Alphonsusadt/Mixed-Signal-Delta-Sigma-ADC/README_F1_v3.md

# F1 v3 — opsi F5: clk komparator dari phi2b via rantai B6_INV
Berkas: top_level/closed_loop/run_closed_loop_f1.py (SALINAN yang menggantikan versi v2 Anda; baseline repo tidak diubah).
Baru: --clk-source {ideal|phi2b-chain} --clk-chain N (N genap). Default tetap ideal.
STATUS: NOT_RUN (hanya --check dan --selftest di sandbox pembuat, subckt dummy).
