Alphonsusadt/Mixed-Signal-Delta-Sigma-ADC/docs/reports/Block4_DAC_Report_EN.pdf

MIXED-SIGNAL IC DESIGN / ENGINEERING REPORT

## BLOCK 4

# Differential 1-Bit Feedback DAC

From an initial estimate to a verified transistor-level baseline

Alphonsus Aditya Putera Wahyudi

Biomedical Engineering / Universitas Gadjah Mada

Technology SKY130A, 1.8 V MOS devices
Clock / load 4 MHz / 1 pF per DAC output
Final DAC | Wn/Wp = 8/256 µm, L = 0.15 µm
Interface | StrongARM + two B01 buffers + SR latch
Evidence | 1,080 cases; 45 PVT points; two waveform reviews
Revision | 1.1 / 2 November 2026

Result status. Function and timing meet the pre-layout campaign criteria that were defined. These results are not a reliability sign-off, post-layout verification, or proof of the dynamic range of the complete ADC.

Independent design portfolio. English.

BLOCK 4 / DIFFERENTIAL 1-BIT DAC | English

## Contents

Revision note 1.1 | ii
Summary for the reader | ii
1 Design objective and scope of the work | 1
2 Theoretical basis and circuit implementation | 2
3 Initial calculation: expectations and assumptions | 4
4 Experimental method and measurement definitions | 6
5 Design evolution: results that changed decisions | 7
6 Final results from the Xschem export | 10
7 Discussion: what agrees and what does not yet | 14
8 Conclusion and the baseline retained | 17
A Reproducibility and final configuration | 18
B Index of experimental evidence | 18
C Summary of the final 45 PVT points | 18
Alphonsus Aditya Putera Wahyudi | i

## Revision note 1.1

Revision 1.1 (2 November 2026) only updates the reference to the system-level target, from about 99 dB to about 75 dB SNDR at OSR 80. No Block 4 data, device size, or conclusion has been changed.

## Summary for the reader

Block 4 converts a one-bit decision into two reference voltages that swap places. The final circuit remains simple: four CMOS transmission gates. The harder work lay in choosing a size that is strong enough in the worst-case condition, ensuring that the decision source is not disturbed by its load, and defining precisely when the output may be considered settled.
The pre-simulation note estimated an ON resistance of about 463 Ω and a settling time of 3.20 ns for a 1 pF load. That figure came from illustrative MOS parameters. The SKY130 model then gave 4.10 kΩ at mid-signal for the initial size Wn/Wp = 2/4 µm, and the actual settling reached 17.77 ns. The reference-selector architecture was therefore correct, but the hypothesis that the initial size was sufficient was rejected by the test results.
The 4/8 µm size improved the nominal condition but passed only 26 of 45 PVT points. The SF, 1.62 V, −40 ◦C case required 137.92 ns. Subsequent exploration led to the 8/256 µm size, which satisfies all 45 standalone points. The large PMOS width is a real cost of this solution: conduction improves, but the control load and parasitic effects increase.
Integration with the StrongARM comparator and the SR latch exposed a second problem. At a 1 mV input difference, the direct connection produced only six correct decisions out of 12 diagnostic cycles. The comparator without the latch and the circuit with ideal isolation were correct again. Two transistor-based B01 buffers were then inserted between the comparator and the latch. This change is supported by a loading diagnosis; its single physical mechanism is not claimed to have been fully isolated.
Final result from the Xschem export | Value
PVT campaign / passing cases | 45/45 / 1080/1080
Cases with 1 pF DAC / without DAC | 540 / 540
Maximum latch decision delay | 5.498 ns
Q/QB reaching the 1% rail band, maximum | 7.853 ns
DAC settling after control is stable, maximum | 6.400 ns
Maximum steady-state error | 1.254 µV
Unresolved decisions / unsettled edges | 0 / 0

The review of the two worst waveforms reproduces the summary figures and checks hold during reset. The total time from the start of the clock edge until the DAC is stable reaches 12.711 ns on the SF waveform. That figure differs from the 6.400 ns settling measured after the gate is stable. This difference in time definitions must be carried into the interface design of the next block.

Design decision. Keep the 8/256 µm DAC, L = 0.15 µm, and the two B01 buffers as the pre-layout function/timing baseline. Repeating optimization passes A–D is not supported by any new finding. The glitch budget, reference current, whole-transistor stress, noise/mismatch, and post-layout remain open.

Alphonsus Aditya Putera Wahyudi | ii

## 1 Design objective and scope of the work

### 1.1 Role of Block 4 in the modulator

The parent project targets a second-order switched-capacitor delta-sigma modulator with a nominal 1.8 V supply, 4 MHz sampling, and OSR 80. The sampling relation gives

Ts =

1
fs

= 250 ns, B =

fs
2 OSR = 25 kHz. | (1)

This bandwidth is an architectural relation, not the measured bandwidth of a finished ADC. The dynamic-range target is a system target: revision 1.0 of this report cited about 99 dB, and on 2 November 2026 the project owner revised it to about 75 dB SNDR at OSR 80 (see the Block 5 report). This revision concerns only the system-level target; the results and limits of Block 4 are unchanged. One-bit feedback is part of the delta-sigma loop [1]; the results of a reference-selector block are not sufficient to state the performance of the complete loop.
Block 4 selects the reference, while the sampling network and charge transfer are handled by Block 5. The non-overlapping clock generator is Block 6. This division matters: the 1 pF load in this report is a test load per output, not evidence that the entire downstream switched-capacitor interface has been modeled.

### 1.2 Questions to be answered

This report assesses whether the reference selection is correct, whether settling meets the budget, whether the nominal pass survives PVT, and whether the circuit keeps working when driven by a transistor-level comparator and latch. The next question is whether the Xschem implementation reproduces the behavior previously tested through the automation netlist.
This document is a retrospective synthesis. The initial expectations are taken from the pre-simulation note [S00]; the conclusions are then traced to experimental results. Rationalizations made after the measurements are not presented as numerical predictions made beforehand.

Table 1: Test specifications and the limits of their interpretation.

Parameter | Value used | Meaning
Nominal supply | 1.8 V | The PVT campaign uses 1.62, 1.8, 1.9 V.
Final nominal reference | 1.2 / 0.6 V | Differs from the initial rail-to-rail 1.8 / 0 V example.
Reference under PVT | 2VDD/3, VDD/3 | Not an absolute 1.2 / 0.6 V reference at every supply.
Integration test load | 1 pF per output | Does not yet include the switches, OTA, and Block 5 impedance.
DAC tolerance | 0.1% of reference span | Per-output settling criterion.
Settling budget | 10 ns after control | Not a 10 ns total clock-to-DAC time.
Latch decision budget | 100 ns | Separate from the 1% rail requirement.
Alphonsus Aditya Putera Wahyudi | 1

## 2 Theoretical basis and circuit implementation

### 2.1 Differential and common-mode transfer

Define the decision D = Q ∈ {0, 1} and D = QB. With ∆VREF = VREFP − VREFN > 0, the ideal outputs are

VP = DVREFP + (1 − D)VREFN, | (2)
VN = DVREFN + (1 − D)VREFP, | (3)
Vd = VP − VN = (2D − 1)∆VREF, | (4)

VCM =

VP + VN
2

=

VREFP + VREFN
2
. | (5)

At the nominal 1.2/0.6 V references, Vd = ±0.6 V, the peak-to-peak differential swing is 1.2 V, and the ideal common mode is 0.9 V. At the 1.62 V PVT point the references become 1.08/0.54 V, so Vd = ±0.54 V and the common mode is 0.81 V.

Q | QB | VP | VN | Vd
0 | 1 | VREFN | VREFP | −∆VREF
1 | 0 | VREFP | VREFN | +∆VREF

The state Q = QB is not part of the ideal operating table. During a transition, both controls are analog voltages with finite rise/fall times; for a moment both may partially turn on different paths. A logic table alone therefore does not explain reference current or glitch.

### 2.2 Four transmission gates and pin order

Each TG consists of one NMOS and one PMOS in parallel. This combination is used to compen-sate for the conduction weakness of each device type over different parts of the signal range [3]. The TG is on when the NMOS gate is high and the PMOS gate is low. The NMOS bulk is tied to GND; the PMOS bulk to VDD.

TG X1
p : Q, n : Q

TG X3
p : Q, n : Q

TG X2
p : Q, n : Q

TG X4
p : Q, n : Q

VREFP

VREFN

VREFN

VREFP

DAC_P

DAC_N

Q = 1: X1, X2 ON
Q = 0: X3, X4 ON
Each TG: NMOS 8/0.15
and PMOS 256/0.15
(µm)

Figure 1: Functional connections of the final DAC. The numbers X1–X4 follow the tested export netlist; these labels are the reference that prevents numbering from being swapped between figures.

Table 2: Pin mapping taken from the final implementation [S22].

Instance A | B | PMOS gate | NMOS gate
X1 | VREFP | DAC_P | QB | Q
X2 | VREFN DAC_N QB | Q
X3 | VREFN DAC_P | Q | QB
X4 | VREFP | DAC_N Q | QB

The TG subcircuit pin order is A B CLK_P CLK_N VDD GND. The DAC pin order is VREFP VREFN Q QB VDD GND DAC_P DAC_N. The DAC contains four NMOS and four PMOS devices, all with L = 0.15 µm, nf=1, mult=1. The final sizes are 8 µm for each NMOS and 256 µm for each PMOS. This DAC cell is independent of the TG used by the CMFB; changing the DAC size does not automatically change the Block 2 cell.

### 2.3 Why the comparator needs a tested interface

The StrongARM produces a dynamic output that returns to its reset state every cycle. The SR latch stores the decision so that Q/QB remain available during that reset. The non-inverting B01 buffer uses two inverters per branch, so the polarity from the comparator to the latch input is

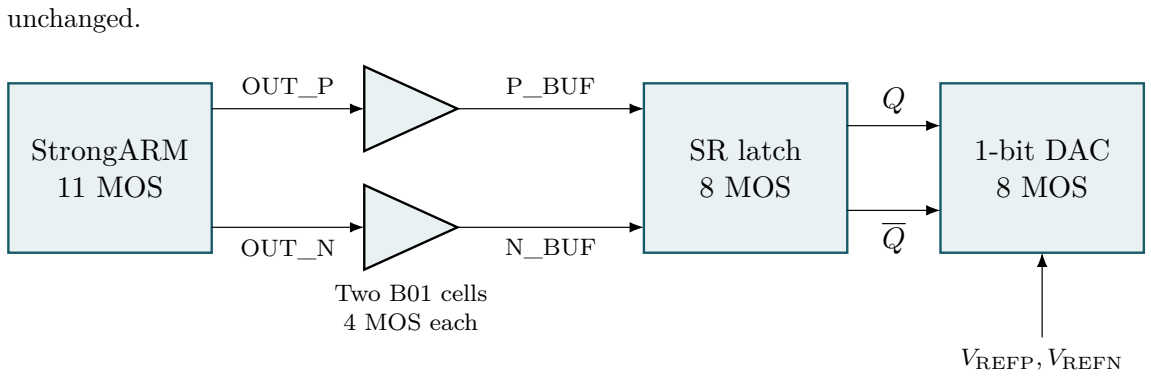
[picture p26: figure]
unchanged.; StrongARM 11 MOS; SR latch 8 MOS; 1-bit DAC 8 MOS; OUT_P; OUT_N; P_BUF; N_BUF; Two B01 cells 4 MOS each; VREFP, VREFN

Figure 2: Final interface: 11 comparator MOS, 8 MOS for the two buffers, 8 latch MOS, and 8 DAC MOS; 35 MOS in total in the loaded configuration.

The buffer is placed between the comparator and the latch. It does not remove the DAC gate load that the latch Q/QB outputs must still drive. This separation explains why DAC characterization and interface testing remain two distinct pieces of work.
The latch core uses two cross-coupled NAND gates with active-low inputs SN and RN:
Q = SN · QB, | QB = RN · Q. | (6)

With SN = 0, RN = 1, Q is set high; with SN = 1, RN = 0, Q is reset low. When the comparator resets and both inputs go high, the latch holds its previous state. Both inputs low is not an allowed storage state because it forces Q and QB high together. This is the physical reason retention must be checked, not assumed from the cell name.
As a local model of regeneration, the comparator output difference can be written vd(t) ≈ vd0 exp(t/τreg), so that

treg ≈ τreg lnVdecision
|vd0|
, | τreg ∼
| Cnode
| gm,reg
. | (7)

This model predicts that a smaller initial signal or a larger node load can slow the decision. No gm or Cnode was extracted here to predict a numerical delay. From the netlist sizes, the NAND-gate proxy seen directly by each comparator output is (2 + 2)0.15 = 0.60 µm²
, whereas the B01 input
is only (0.5 + 1)0.15 = 0.225 µm²
. The reduction of the proxy to 37.5% supports the choice of a small buffer; it is not a measurement of the actual capacitance.

## 3 Initial calculation: expectations and assumptions

### 3.1 ON-resistance model

To obtain an estimate before using the PDK model, the linear channel conductance is approxi-mated by

gn ≈ µnCox

Wn
L
max(VDD − Vsig − VT n, 0), | (8)

gp ≈ µpCox

Wp
L
max(Vsig − |VT p|, 0), | (9)

RON ≈ (gn + gp)

−1
. | | (10)

This equation simplifies the effects of body bias, short channels, and voltage change along the transition. The initial note used µnCox = 200 µA/V²

| , µpCox = 80 µA/V² | , and VT n = |VT p| =
0.45 V. These values are illustrative assumptions, not SKY130 extraction results.

With Wn/Wp = 2/4 µm, L = 0.15 µm, VDD = 1.8 V, and Vsig = 0.9 V:

gn = (200 × 10−6
)(2/0.15)(0.45) = 1.20 mS, | (11)
gp = (80 × 10−6
)(4/0.15)(0.45) = 0.96 mS, | (12)
RON ≈ 1/(2.16 mS) = 462.96 Ω. | (13)

The initial hypothesis was clear: if this resistance represents the path actually used, the inherited 2/4 size should be sufficient for the chosen settling budget. It is this hypothesis that was tested, not one assumed to be true because the equation looked reasonable.

### 3.2 RC settling derivation and resistance budget

For one branch with an ideal reference, constant RON, and capacitor CL,

CL

dVo
dt =

Vtarget − Vo

| RON
| . | (14)

The solution gives the normalized residual

en(t) = exp[−t/(RONCL)], | tϵ = RONCL ln(1/ϵ). | (15)

With CL = 1 pF and ϵ = 10−3
,
t0.1%,initial = 462.96 × 10−12 ln(1000) = 3.198 ns. | (16)

Conversely, the 10 ns budget gives the guideline

RON ≲

10 ns
1 pF ln(1000) = 1.448 kΩ. | (17)

For loads of 0.1 pF and 20 fF, the same model predicts 0.320 ns and 0.064 ns, respectively. Values this small can no longer be separated from the 1 ns control edge and the internal switch capacitance; the prediction only shows the ideal RC scale.

### 3.3 Why a single RC constant can miss

The effective source and drain of the TG change with the signal. When both terminals are near mid-supply, the NMOS VGS and PMOS VSG both shrink, while bulk bias raises the magnitude of the effective threshold. The simple body-effect form for an NMOS is

VT = VT0 + γ

(√
2ϕF + VSB −

√
2ϕF

)
. | (18)

No value of γ was extracted in this work. The equation explains the direction of the effect; it does not compute the numerical threshold of the final transistors. The illustrative 0.45 V threshold is not sufficient to represent all bias conditions of the standard model used.
If the current varies strongly with voltage, the transition time is better viewed through

t = CL

∫ Vb

Va

dV

Ipath(V )

, | (19)

with the direction of integration adjusted for charging or discharging. A weakly conducting region can dominate the integral even when the resistance near the rail is low. Therefore the minimum RON cannot represent the whole transition.

### 3.4 Reference energy and the cost of the control load

One bit change swaps both outputs. For two equal loads CL, the charge moved in each branch is

∆q = CL∆VREF = 1 pF(0.6 V) = 0.6 pC. | (20)

The ideal net reference energy for one reversal of the output pair is

Eref = VREFPCL∆VREF − VREFNCL∆VREF = CL∆V

2
REF = 0.36 pJ. | (21)

If α denotes the probability that the bit changes per sample,

Pref,ideal = αfsCL∆V

2
REF. | (22)

The result is 1.44 µW for α = 1 and 0.72 µW for α = 0.5. For the initial rail-to-rail 1.8/0 V example, the corresponding figures are 3.24 pJ and 12.96 µW for α = 1. This ninefold reduction comes from the change of reference span, not from evidence that efficiency improved ninefold through size optimization.
Each Q or QB drives two DAC NMOS and two DAC PMOS devices. The gate-area proxy driven by one node is
Agate,Q = 2(Wn + Wp)L. | (23)

Its value grows from 1.8 µm²

for 2/4 to 79.2 µm²
for 8/256, a factor of 44. Using only the initial illustration Cox,ef f = 5 fF/µm²
, the capacitance proxy changes from 9 to 396 fF per Q/QB. The 396 fF figure is not an extracted capacitance; overlap, channel bias, and routing are not covered. Likewise, ∑W L of the eight DAC MOS devices increases from 3.6 to 158.4 µm²
. This is a channel
metric, not layout area. It is useful for comparing candidates but excludes contacts, diffusion, wells, spacing, and metal.

### 3.5 Glitch and charge on the released node

A simple coupling estimate gives

∆Vf t ∼

Ccouple
CL
∆Vcontrol, | ∆Vq ∼

∆qinj
CL
. | (24)

The initial example Ccouple = 2 fF gives 3.6 mV at 1 pF and an 1.8 V edge. This is only an arithmetic example. The change in final dimensions and the sum of several mechanisms mean it is not a prediction of the final amplitude. Parasitic gate coupling and channel charge transfer can disturb analog nodes; adding width to reduce resistance also brings a parasitic cost [4].

## 4 Experimental method and measurement definitions

### 4.1 From the automation netlist to the Xschem export

Python automation assembles the decks, runs ngspice, reads the waveforms, and tests the criteria. Python does not replace the electrical circuit solution. The electrical results in this report come from ngspice in the user’s environment with the SKY130 model, not from a software test fixture. Code inspection and dry runs only validate the assembly and data analysis.
The early stage used a parametric netlist backend. After the size and interface were chosen, the schematic was built in Xschem and exported. The final tests use the fixed sizes from that export. Stage names and result rows distinguish these two phases so that backend results are not simply equated with schematic results.

Table 3: Test sequence and the design question of each.

Stage Test | Question
4A | Logic and output values | Is the reference selected with the correct polarity?
4B | DC RON, load, settling | How strong is the switch over the tested signal range?
4C | Edges, skew, node release | What are the transient cost and the control asymmetry?
4D | 45 standalone PVT points | Does the nominal size withstand the defined variation?
4E | Comparator–buffer–latch–DAC | Does the complete interface work with transistor drivers?

### 4.2 DC resistance: small differential measurement

The fixture applies a voltage difference δ = 1 mV symmetrically about the common-mode voltage, then compares the currents for positive and negative polarity:

GON (VCM ) = −

I+(VCM ) − I−(VCM )
2δ

, RON = G

−1
ON . | (25)

The minus sign follows the SPICE source-current convention in the deck. A 61-point sweep covers almost the entire 0–VDD range. Comparing the two polarities removes the first-order common-mode leakage component. The result is still a local measurement at small VDS; it is not a single constant resistance for all transitions.

### 4.3 Definitions of settle and hold

For each bit, the per-branch target is set by Equation (4). The test error is

e(t) = max (|VP − VP,target|, |VN − VN,target|). | (26)

The tolerance etol = 0.001∆VREF is 0.60 mV nominally and 0.54 mV at VDD 1.62 V. Settling is determined from the last sample that still fails, then the next sample that meets the tolerance through the end of the window with a minimum persistence time of 20 ns. The first crossing alone is not sufficient.
With ideal control, the settling start is the completion of both control ramps. With transistor integration, the start is when Q and QB both enter the 1% rail band. The latch decision delay uses a 30%/70% logic threshold, while the comparator is judged by the polarity of its regenerative output. These three metrics are deliberately not merged.
With t0 the start of the clock edge and tg the time at which control reaches the rail,
tDAC,af ter = tDAC,stable − tg, | tclock→DAC = tDAC,stable − t0. | (27)

Adding two maxima from different cases is not a total measurement of one waveform. The total must be computed on the same transition.

### 4.4 Numerical validity and the limits of PASS status

The final deck uses the trapezoidal method, reltol=1e-5, vntol=1e-8, abstol=1e-13, and a maximum time step of 0.05 ns. The log confirms the 10−6 geometry scale and the ngspice-46 simulator. Waveforms are saved with wrdata; the transient facilities and control language follow the ngspice documentation [5].
A case that times out or fails to load a Python module is not an electrical result that fails the specification; it must be fixed and rerun until valid data are available. Conversely, an ngspice process that finishes is not evidence that the circuit passes. The pipeline requires a valid execution status, complete data, and function and timing checks. The cache checks the identity of the deck, simulator, and model dependencies so that old results are not used for a changed configuration.

## 5 Design evolution: results that changed decisions

### 5.1 Initial 2/4 size: the model was too optimistic

The nominal DC result shows RON(0.9 V) = 4098.08 Ω, a minimum of 463.21 Ω, and a maximum of 5802.37 Ω [S02]. The minimum value, which happens to be close to the initial estimate, does not validate the mid-signal estimate. Comparison at the same mid-point gives

RON, sim(0.9 V)
RON, initial =

4098.08
462.96
| = 8.85. | (28)

Settling at the 1.2/0.6 V reference and a 1 pF load reached 17.77 ns, whereas the initial estimate was only 3.20 ns. This difference supports rejecting the illustrative parameters as a quantitative sizing tool. The available data do not separate the contributions of threshold, mobility, and body effect numerically; the physical explanation is consistent with TG bias but is not an extraction of the mechanism.

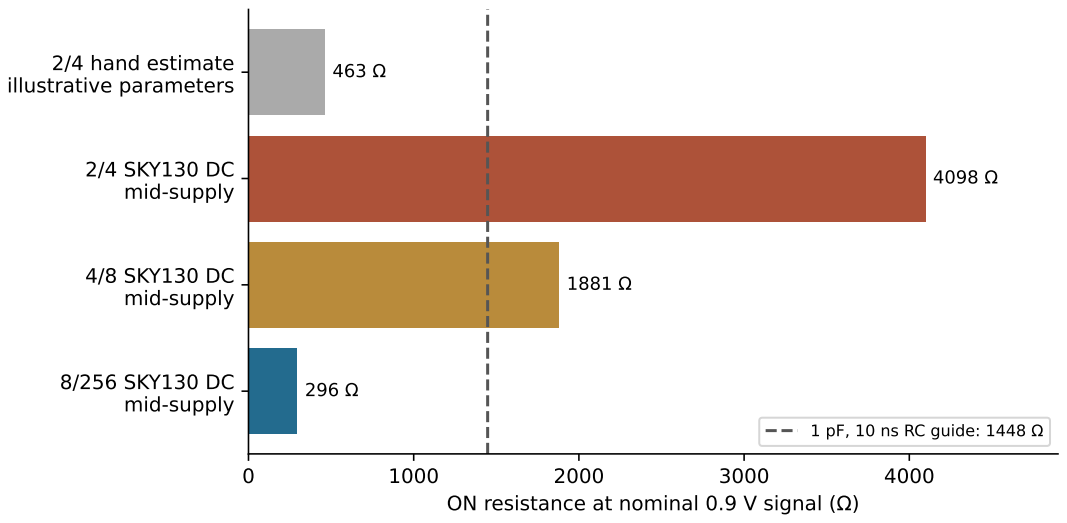
[picture p27: figure]
2/4 hand estimate illustrative parameters; 2/4 SKY130 DC mid-supply; 4/8 SKY130 DC mid-supply; 8/256 SKY130 DC mid-supply; 1 pF, 10 ns RC guide: 1448

ON resistance at nominal 0.9 V signal ( )

Figure 3: Initial estimate versus DC resistance at the same signal points. The dashed line is the 1 pF/10 ns RC guideline, not a universal threshold for every transition.

5.2 4/8 size: a nominal improvement is not enough

Doubling both widths reduces the mid-point RON from 4098 to 1881 Ω. The maximum settling of the nominal sweep becomes 8.763 ns; the 4/8 choice has the smallest ∑W L among the candidates

meeting that stage [S03]. Test 4A passes 6/6 and 4C completes 54/54: 45 switching transients plus nine release characterizations [S04,S05].
However, PVT passes only 26/45. At SF, 1.62 V, −40 ◦C, settling grows to 137.923 ns. A reduced time step gives 137.893 ns, a change of about 0.022%, so this large failure does not disappear through that refinement alone [S06,S07]. This result refutes the hypothesis that a nominal pass can be transferred directly to the whole PVT grid.
DC measurement at the failing condition finds a maximum RON of about 145.18 kΩ. At the same corner, settling for 20 fF, 0.1 pF, and 1 pF is 4.825, 15.662, and 137.923 ns [S08]. The load dependence supports the explanation of limited conduction. The local maximum resistance must not be directly multiplied into a full settling prediction because it does not hold along the entire voltage path.

### 5.3 Final 8/256 size and the cost of the solution

Worst-condition screening shows that adding NMOS alone is not sufficient: 8/8 still requires 128.70 ns, whereas 8/16 and 8/32 give 70.61 and 38.50 ns [S09]. After the search was extended, the selected 8/256 candidate passes 45/45 with a standalone maximum of 7.084 ns [S10]. This candidate is not evidence of a global optimum. The size grid is limited, and the area objective does not yet include layout cost, power, and all transient limits.
As a retrospective check, assuming ts ∝ 1/Wp from the 8/32 point would give Wp,trial ≈ 32(38.50/10) = 123.2 µm for a 10 ns target. However, the same assumption predicts only 38.50(32/256) = 4.81 ns at 8/256, faster than the actual result of 7.084 ns. Inverse width scaling therefore helps set the search direction but is not sufficient to determine the final size. Capacitance growing with width and a conduction path that is not purely PMOS may limit the improvement; their contributions were not extracted separately. This retrospective calculation is not claimed to have been made before the search took place.

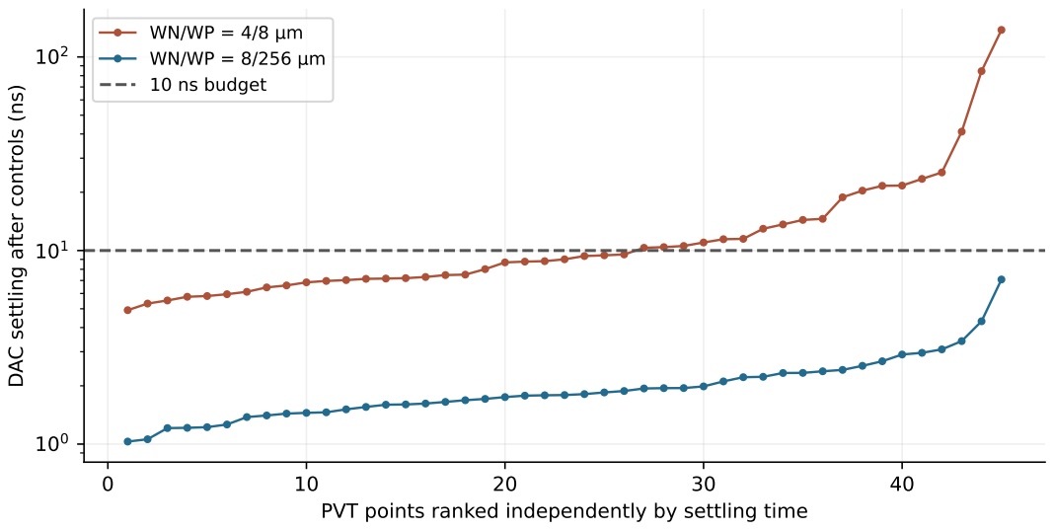
[picture p28: figure]
DAC settling after controls (ns); 10 ns budget

PVT points ranked independently by settling time

Figure 4: Distribution of settling over the 45 standalone PVT points. The points of each curve are sorted independently; the horizontal axis is not the same corner pair. The 4/8 size fails 19 points, whereas 8/256 meets this entire grid.

At nominal, the final candidate has a mid-point RON of 296.34 Ω, a maximum of 365.85 Ω, and a maximum 4B sweep settling of 1.880 ns [S11]. The RC model using the maximum resistance gives 365.85 Ω × 1 pF × ln(1000) = 2.527 ns. The nanosecond scale agrees, but the difference between 2.527 and 1.880 ns remains plausible because the voltage has already moved during the control ramp and the resistance is not constant. The simple model succeeds as a scale check, not as a precise predictor.

### 5.4 The 1 mV integration problem and loading diagnosis

After the standalone DAC passed, integration without a buffer completed 24 simulations, but only 18 met the criteria. The six failures were at the 1 mV input difference, including the configuration without a DAC [S13]. Blaming the DAC size alone therefore does not explain all of the data.

Table 4: Experiments separating the influence of loading [S14].

Configuration | Comparator correct | Output correct | Hold correct
Original connection, 1 mV | 6/12 | 6/12 | 6/12
Original connection, half time step | 6/12 | 6/12 | 6/12
Comparator without latch | 12/12 | 12/12 | –
Latch with diagnostic ideal isolation | 12/12 | 12/12 | 12/12
Original connection, 5 mV | 12/12 | 12/12 | 12/12

Ideal isolation was used to test the cause, not kept as a physical solution. Together, these results support an influence of the comparator–latch interaction at small signals. The terms loading, back-action, and regeneration describe possible mechanisms; these data do not measure the contribution of each separately.
Four physical buffer sizes B01–B04 were tested and all passed the six 1 mV screening cases. B01 was chosen because its additional channel proxy is the smallest, 1.35 µm²
for both branches. Each
buffer uses an inverter with Wn/Wp = 0.5/1 µm followed by 1/2 µm, all with L = 0.15 µm. B01 then passed nominal verification 24/24 [S15]. This selection proves the sufficiency of B01 within the test space, not that a larger buffer would never be needed at other loads.

### 5.5 Moving the design to an inspectable schematic

The Xschem DAC export passes 4A 6/6 and standalone PVT 45/45, with a maximum of 7.073 ns [S16,S17]. The value is close to the backend 7.084 ns but is reported separately. The complete integration export then passes 24/24 nominal [S18].
The final netlist shows MOS bulks connected, consistent interface pins, two physical B01 buffers, and fixed 8/256 sizes. In the automation deck, the two buffers are wrapped inside a subcircuit named SR_Latch, while the two-NAND core is kept as SR_Latch_CORE. This hierarchical placement does not mean the buffers disappeared, and it does not require adding a second buffer.

## 6 Final results from the Xschem export

### 6.1 Campaign coverage and passes

The final campaign contains five corners TT/SS/FF/SF/FS, three supplies 1.62/1.8/1.9 V, and three temperatures −40/27/125 ◦C. Thus

NP V T = 5 × 3 × 3 = 45. | (29)

At each point there are four input-difference magnitudes 1/5/10/50 mV, three patterns alternating/repeats/PRBS, and two configurations loaded/unloaded:

Ncase = 45 × 4 × 3 × 2 = 1080. | (30)

Of these, 540 cases connect the DAC with a 1 pF load per branch; the other 540 test the comparator–buffer–latch without a DAC. All use a fixed input common mode of 0.9 V; this is not a common-mode sweep. The analog and reference sources are ideal low-impedance sources; the PRBS pattern uses a fixed seed, not random mismatch samples.
All cases have OK execution status and pass the function, settling, and preliminary criteria. There is no unresolved decision, unsettled gate, or unsettled edge. The case count and the uniqueness of point/ID pairs were rechecked from the CSV [S19,S20,S21]. The 1080/1080 figure is deterministic coverage, not an estimate of production yield.

1.62 | 1.80 | 1.90

40

27

Latch decision (ns)

125

Temperature (°C)

4.92 | 4.12 | 3.83
4.91 | 4.24 | 3.94
5.04 | 4.43 | 4.18

TT

1.62 | 1.80 | 1.90

40

27

125

5.50 | 4.59 | 4.27
5.43 | 4.61 | 4.33
5.50 | 4.82 | 4.56

SS

1.62 | 1.80 | 1.90

40

27

125

4.45 | 3.77 | 3.55
4.43 | 3.89 | 3.68
4.70 | 4.16 | 3.99

FF

1.62 | 1.80 | 1.90

40

27

125

4.94 | 4.07 | 3.76
4.87 | 4.14 | 3.86
4.91 | 4.28 | 4.06

SF

1.62 | 1.80 | 1.90

40

27

125

4.94 | 4.22 | 3.95
5.00 | 4.34 | 4.06
5.23 | 4.62 | 4.39

FS

1.62 | 1.80 | 1.90
| VDD (V)

40

27

DAC after gates (ns)

125

Temperature (°C)

2.00 | 0.85 | 0.60
1.60 | 0.75 | 0.45
0.50 | 0.00 | 0.00
1.62 | 1.80 | 1.90
| VDD (V)

40

27

125

4.00 | 1.40 | 0.95
2.20 | 1.15 | 0.80
1.25 | 0.30 | 0.00
1.62 | 1.80 | 1.90
| VDD (V)

40

27

125

1.20 | 0.40 | 0.20
0.90 | 0.25 | 0.05
0.10 | 0.00 | 0.00
1.62 | 1.80 | 1.90
| VDD (V)

40

27

125

6.40 | 0.85 | 0.60
1.45 | 0.80 | 0.55
0.70 | 0.15 | 0.00
1.62 | 1.80 | 1.90
| VDD (V)

40

27

125

2.10 | 0.95 | 0.60
1.85 | 0.70 | 0.35
0.15 | 0.00 | 0.00

Final Xschem campaign: maxima across 24 cases per PVT point

Figure 5: Maximum over the 24 cases at each PVT point. Top row: latch decision delay. Bottom row: DAC settling after control is stable, maximum over the loaded cases. All figures in ns.

### 6.2 Worst metrics and where they occur

Table 5: Extremes of the final campaign. The values come from different cases and are not summed into a single waveform.

Metric | Maximum Corner / VDD / temp. / ID
Latch delay | 5.498 ns | SS / 1.62 / 125 / 0001
Gate reaching 1% rail | 7.853 ns | SS / 1.62 / 125 / 0001
DAC settling after gate | 6.400 ns | SF / 1.62 / −40 / 0013
Steady-state error | 1.254 µV SS / 1.62 / 125 / 0015
Excursion beyond reference | 38.775 mV FS / 1.90 / −40 / 0019
Peak reference current | 2.207 mA | FF / 1.90 / 27 / 0001
DAC terminal-pair proxy | 1.913 V | SF / 1.90 / −40 / 0007
Transient common-mode excursion | 229.105 mV SS / 1.62 / −40 / 0001

A settling time of 6.400 ns leaves 3.600 ns against the 10 ns post-gate budget. The 1% rail limit uses 16.2 mV at VDD 1.62 V. These two kinds of tolerance must not be confused with the 0.54 mV analog DAC tolerance.

### 6.3 Waveform review: slowest decision

The case SS/1.62 V/125◦C, ID 4E_0001, uses an input difference of ±1 mV. The waveform has 62,794 samples up to 3.1 µs. Recomputation gives a latch delay of 5.498 ns, a gate time of 7.853 ns, and an additional DAC settling of 1.200 ns. The maximum total clock-to-DAC time in this waveform is 9.053 ns [S23,S24].

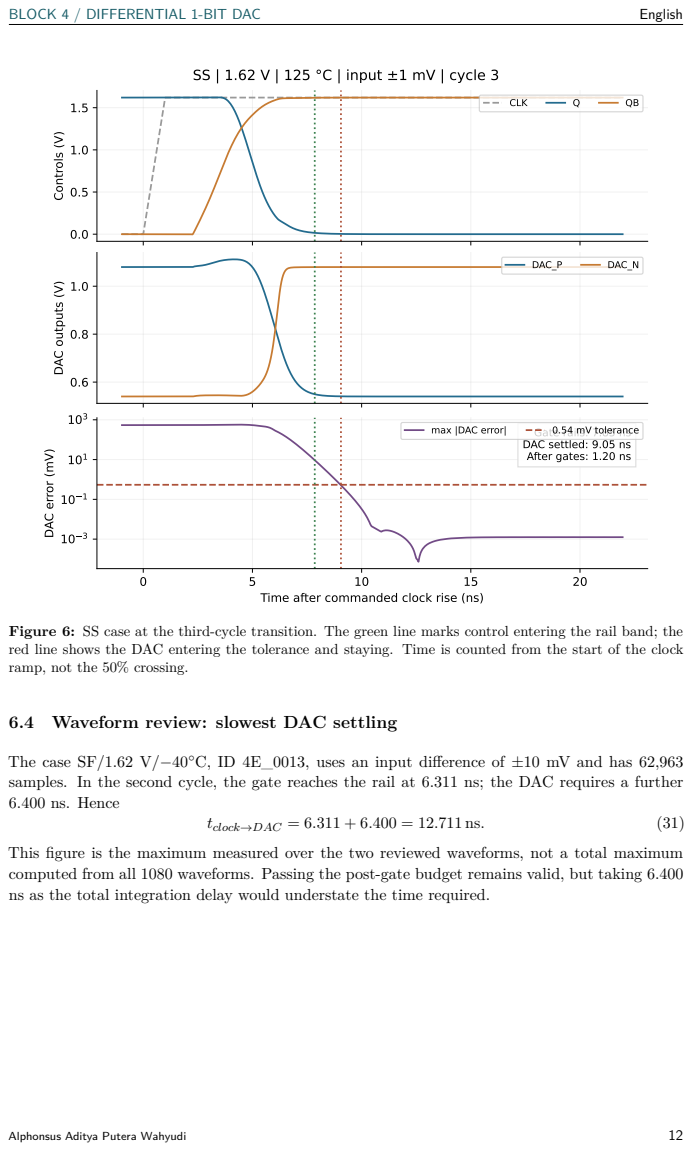
[picture p29: page 15]
Controls (V); CLK; DAC outputs (V); DAC_P; DAC_N; max |DAC error|; 0.54 mV tolerance; tclock→DAC = 6.311 + 6.400 = 12.711 ns.

SS | 1.62 V | 125 °C | input ±1 mV | cycle 3

Gate rails: 7.85 ns
DAC settled: 9.05 ns
After gates: 1.20 ns

DAC error (mV)

Time after commanded clock rise (ns)

Figure 6: SS case at the third-cycle transition. The green line marks control entering the rail band; the
red line shows the DAC entering the tolerance and staying. Time is counted from the start of the clock
ramp, not the 50% crossing.

6.4 Waveform review: slowest DAC settling

The case SF/1.62 V/−40◦C, ID 4E_0013, uses an input difference of ±10 mV and has 62,963
samples. In the second cycle, the gate reaches the rail at 6.311 ns; the DAC requires a further
6.400 ns. Hence

This figure is the maximum measured over the two reviewed waveforms, not a total maximum
computed from all 1080 waveforms. Passing the post-gate budget remains valid, but taking 6.400
ns as the total integration delay would understate the time required.

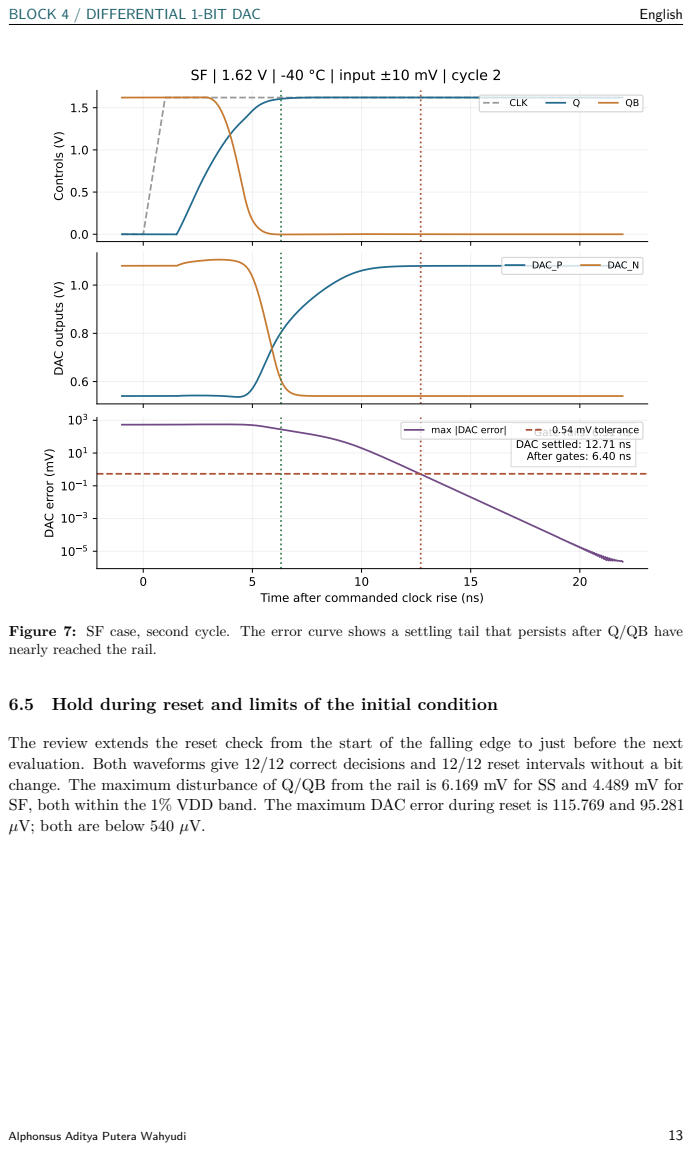
[picture p30: page 16]
Controls (V); CLK; DAC outputs (V); DAC_P; DAC_N; max |DAC error|; 0.54 mV tolerance

SF | 1.62 V | -40 °C | input ±10 mV | cycle 2

Gate rails: 6.31 ns
DAC settled: 12.71 ns
After gates: 6.40 ns

DAC error (mV)

Time after commanded clock rise (ns)

Figure 7: SF case, second cycle. The error curve shows a settling tail that persists after Q/QB have
nearly reached the rail.

6.5 Hold during reset and limits of the initial condition

The review extends the reset check from the start of the falling edge to just before the next
evaluation. Both waveforms give 12/12 correct decisions and 12/12 reset intervals without a bit
change. The maximum disturbance of Q/QB from the rail is 6.169 mV for SS and 4.489 mV for
SF, both within the 1% VDD band. The maximum DAC error during reset is 115.769 and 95.281
µV; both are below 540 µV.

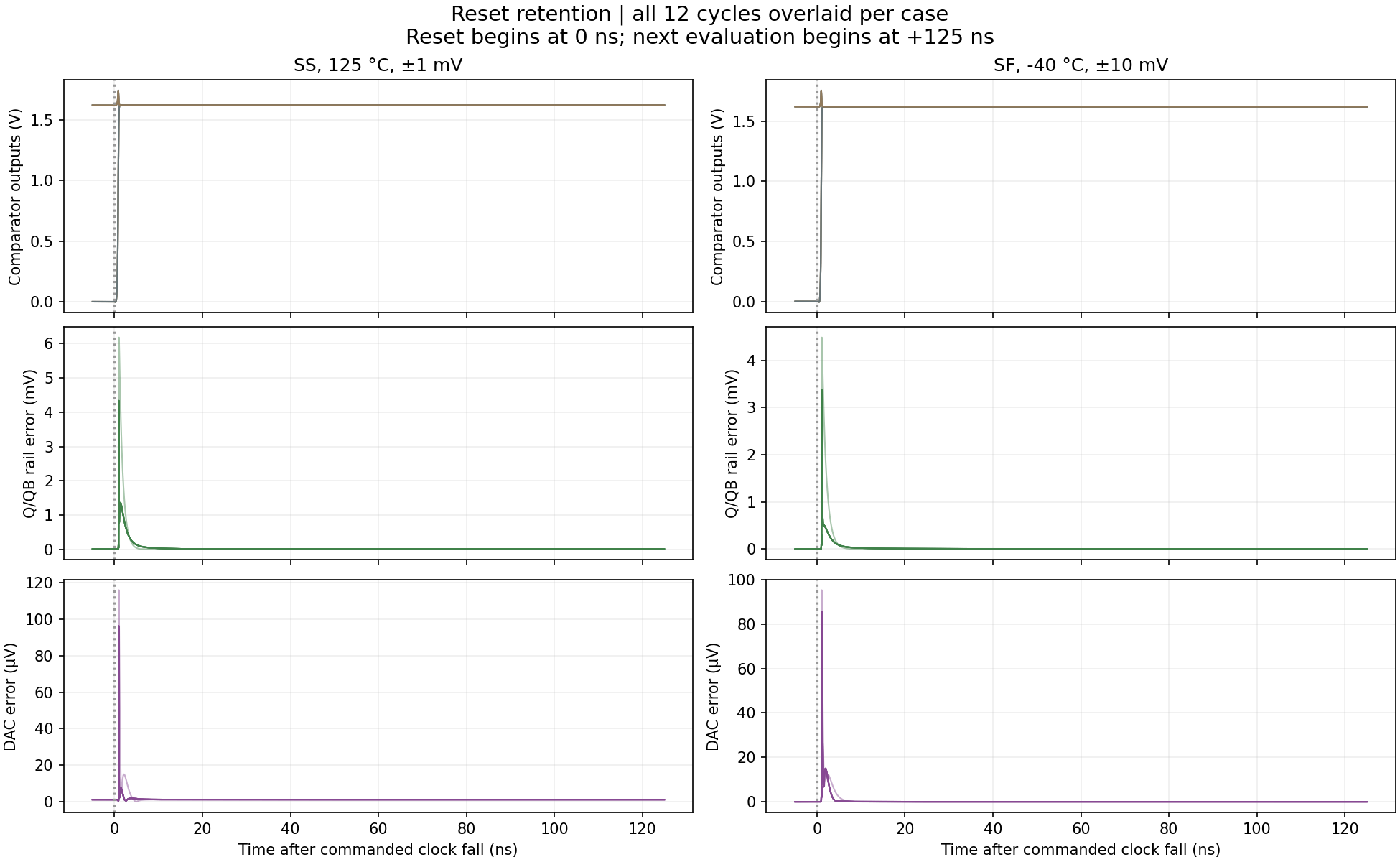
[picture p31: figure]

Figure 8: Twelve reset intervals overlaid per case. The comparator returns high; the latch rail error and DAC disturbance decay without a change of decision. The right and left axes have different scales.

The first cycle already has Q=0 from the DC operating-point solution. A zero delay in the first row is therefore not evidence that the circuit has a physical zero delay or a guaranteed random startup. The two waveforms contain 22 bit changes that were actually tested after the two initial states. No warnings, errors, or early terminations were found in either log.

## 7 Discussion: what agrees and what does not yet

### 7.1 Reconciling hypotheses with evidence

Table 6: Expectations, results, and updated design understanding.

Expectation | Test result | Explanation / decision
Four TGs give ±∆VREF outputs with fixed CM in the steady state. | Polarity and steady state agree. | Transfer structure kept; the CM transient must still be assessed.
2/4 suffices because the initial RC is 3.20 ns. | Settling 17.77 ns; mid-point DC 4.10 kΩ. | Illustrative parameters too optimistic; sizing uses the PDK model.
4/8, which passes nominal, suffices for PVT. | Only 26/45; worst 137.92 ns. | Nominal does not represent the corners; worst-case optimization needed.
A standalone circuit that passes can be combined directly. | 1 mV fails at the comparator–latch connection. | The dynamic interface must be tested; two B01 give a verified physical solution.
A fixed-size schematic reproduces the netlist solution. | 24/24 nominal and 1080/1080 PVT pass. | Xschem export baseline accepted within the test coverage.

The early failure does not mean the RC equation is useless. It gives the correct cause-and-effect relation: a larger load or weaker conduction lengthens settling. What failed was the use of a single resistance value that did not yet represent the actual transistors and bias.

### 7.2 Power: aligning the domains before comparing

The engine power metric integrates the net energy from VDD and both references; with ideal control drivers, the Q/QB source power is also counted. In integration, the power includes the comparator, buffers, latch, and DAC. It is not DAC power alone.
As a measured example, TT/1.8 V/27◦C, 1 mV alternating loaded, has an average source power of 7.661 µW. The earlier ideal reference-load estimate was only 1.44 µW at full activity. The difference must not be called a fivefold theory error: the source coverage differs, there is gate and decision-circuit activity, and the 100–3100 ns window contains a limited bit sequence. The maximum over the entire campaign is 12.033 µW, also for the full interface [S19].

### 7.3 Non-idealities that cannot yet be labeled as passing

The output excursion beyond the reference range reaches 38.775 mV in the final campaign. This metric does not count the whole difference from the target while the intended transition is still in progress. The peak reference current of 2.207 mA includes load charging, parasitics, and possible overlap; it is not a pure shoot-through measurement.

Table 7: Transient cost in the standalone 4C screening, size 8/256 [S12].

Load per output | Switching cases | Max. excursion (mV) Max. settling (ns)
20 fF | 15 | 221.973 | 0.444
0.1 pF | 15 | 185.545 | 0.558
1 pF | 15 | 65.493 | 1.913

This screening combines three control edges (0.2, 1, 5 ns) and five skews (−2, −0.5, 0, 0.5, 2 ns). An ideal Q/QB source can sustain a different overlap than a transistor driver. For that reason, the 221.973 mV maximum at light load and the maximum current of about 8.93 mA at that stage must not be combined with the final campaign maxima as a single operating condition. The result is still important: a light load settles faster but does not automatically see a smaller glitch. The backend release test of the final size at 1 pF gives a change of 38.65–41.04 mV, or a CL∆V proxy of about 38.65–41.04 fC [S12]. The node is deliberately released from the reference so that the disturbance is stored. This differs from a DAC that remains connected to the reference after switching. The proxy mixes injection, feedthrough, and drift; it does not extract pure channel charge. A characterization status that passes while the glitch limit is empty does not prove that the system charge-error limit is met.
A correct steady-state common mode also does not erase a transient excursion of up to 229.105 mV. In subsequent circuits its effect depends on the sampling phase, the impedance, and the OTA response. Integration with the actual SC load must therefore check when this transient becomes visible to the sensitive capacitors.

### 7.4 Model validity is not a reliability sign-off

The SKY130 documentation gives the model bias range for 1.8 V devices, including magnitude ranges of VGS and VDS up to 1.95 V [2]. That range does not automatically become a lifetime limit applicable to every terminal pair. The 1.913 V maximum proxy covers only DAC MOS terminal pairs. Signed bias against the bulk and the internal comparator/buffer/latch transistors are not yet covered in the full stress decision.
Three final configuration limits are still null: maximum glitch, maximum peak reference current, and terminal-voltage limit. Because they are not set, a preliminary_pass=True result must not be written as passing all specifications. Likewise, the 0.1% settling tolerance corresponds to an amplitude ratio of 10−3
; it is not evidence of system dynamic range (initial target 99 dB, revised to about 75 dB at OSR 80). The system error and noise allocation has not been derived from that target.

## 8 Conclusion and the baseline retained

Block 4 has reached a pre-layout baseline that can be traced from theory, calculation, failure, and diagnosis to schematic export. The four TGs still implement the desired transfer. The main changes are the enlargement of the devices to 8/256 and the addition of two B01 buffers at the comparator–latch interface.
The strength of this result lies in the order of proof: illustrative parameters were tested and rejected when they did not agree; a nominal pass was not used to hide a PVT failure; ideal sources were used only for diagnosis; and the final solution was verified again with transistors and the Xschem export. All 1080 cases meet the defined campaign criteria.
This size is not called a global optimum and has not been translated into a layout that passes DRC/LVS/PEX. The next work uses the same baseline to assess the interaction with the switch network and capacitors of Block 5. New checks should answer a change of load or interface assumption, not repeat the entire sweep without reason.

Statement of result usable in a portfolio. A differential one-bit SKY130 feedback DAC was designed and verified at the transistor level, including diagnosis of nominal/PVT failures, repair of the comparator–latch interface, and retesting of the Xschem export at 45 PVT points and 1080 deterministic cases. This claim is limited to pre-layout function and timing according to the documented criteria.

## A Reproducibility and final configuration

The model recorded in the deck uses the SKY130A installation through Ciel with the revision identity

7b70722e33c03fcb5dabcf4d479fb0822d9251c9

This identity refers to the installation that was tested, not a claim that all versions of the online documentation are exactly the same. The PDK model is not redistributed in the report package. Final campaign command in the user’s automation directory:

python3 stage_4E_buffer_pvt.py \
--config 4E_Xschem_Verification/config_nominal.json \
--dac-netlist 4E_Xschem_Verification/dac_xschem.inc \ --block3-netlist 4E_Xschem_Verification/block3_xschem_b01.inc \ --all-inputs \
--pdk /foss/pdks/sky130A/libs.tech/combined/sky130.lib.spice \ --workers 2 --out results/4E_xschem_pvt_full

This package includes snapshots of the engine and runner to explain the method, not the PDK or the complete simulation environment. Netlist/config files are in sources/; result data are in data/. Original names and SHA-256 are recorded in data/source_manifest.json. A ZIP of the two raw waveforms, the pre-simulation note, the per-cycle tables, and the review results are also included as evidence that can be rechecked.
To compile the report, run XeLaTeX twice, for example xelatex main_en.tex, or upload the package to Overleaf and select the XeLaTeX compiler. The Indonesian version uses main_id.tex. Both documents use the same numerical evidence.

## B Index of experimental evidence

Evidence Content and role

S00 | Design note written before simulation
S01–S02 | 2/4 baseline: logic, resistance, and settling
S03–S05 | Nominal search and verification of the 4/8 size
S06–S09 | PVT failure, refinement, and conduction diagnosis
S10–S12 | 8/256 size: PVT, resistance, skew, release
S13–S14 | Unbuffered integration and isolation experiments
S15 | B01–B04 screening and nominal verification of B01
S16–S17 | Logic and standalone PVT from the Xschem DAC export
S18 | Nominal integration from the Xschem export, 24 cases
S19 | All 1080 result rows of the final integration PVT campaign
S20–S21 | Aggregation over 45 points and final campaign summary
S22 | User-owned integration netlist export
S23 | Two worst cases: waveforms, decks, configuration, logs
S24 | Independent waveform review and per-cycle tables

## C Summary of the final 45 PVT points

The values below are maxima per point, not a single transition containing all maxima at once. Each point contains 24 cases and all pass the campaign criteria.

Corner VDD (V) Temp. (◦C) Decision (ns) DAC (ns)

TT | 1.62 | -40 | 4.924 | 2.000
TT | 1.62 | 27 | 4.911 | 1.600
TT | 1.62 | 125 | 5.041 | 0.500
TT | 1.80 | -40 | 4.122 | 0.850
TT | 1.80 | 27 | 4.236 | 0.750
TT | 1.80 | 125 | 4.435 | 0.000
TT | 1.90 | -40 | 3.834 | 0.600
TT | 1.90 | 27 | 3.938 | 0.450
TT | 1.90 | 125 | 4.176 | 0.000
SS | 1.62 | -40 | 5.497 | 4.000
SS | 1.62 | 27 | 5.428 | 2.200
SS | 1.62 | 125 | 5.498 | 1.250
SS | 1.80 | -40 | 4.585 | 1.400
SS | 1.80 | 27 | 4.606 | 1.150
SS | 1.80 | 125 | 4.822 | 0.300
SS | 1.90 | -40 | 4.269 | 0.950
SS | 1.90 | 27 | 4.332 | 0.800
SS | 1.90 | 125 | 4.556 | 0.000
FF | 1.62 | -40 | 4.450 | 1.200
FF | 1.62 | 27 | 4.430 | 0.900
FF | 1.62 | 125 | 4.696 | 0.100
FF | 1.80 | -40 | 3.770 | 0.400
FF | 1.80 | 27 | 3.889 | 0.250
FF | 1.80 | 125 | 4.162 | 0.000
FF | 1.90 | -40 | 3.551 | 0.200
FF | 1.90 | 27 | 3.678 | 0.050
FF | 1.90 | 125 | 3.992 | 0.000
SF | 1.62 | -40 | 4.945 | 6.400
SF | 1.62 | 27 | 4.874 | 1.450
SF | 1.62 | 125 | 4.908 | 0.700
SF | 1.80 | -40 | 4.074 | 0.850
SF | 1.80 | 27 | 4.142 | 0.800
SF | 1.80 | 125 | 4.276 | 0.150
SF | 1.90 | -40 | 3.764 | 0.600
SF | 1.90 | 27 | 3.858 | 0.550
SF | 1.90 | 125 | 4.060 | 0.000
FS | 1.62 | -40 | 4.943 | 2.100
FS | 1.62 | 27 | 4.999 | 1.850
FS | 1.62 | 125 | 5.227 | 0.150
FS | 1.80 | -40 | 4.218 | 0.950
FS | 1.80 | 27 | 4.342 | 0.700
FS | 1.80 | 125 | 4.624 | 0.000
FS | 1.90 | -40 | 3.946 | 0.600
FS | 1.90 | 27 | 4.058 | 0.350
FS | 1.90 | 125 | 4.388 | 0.000

## References

[1] B. E. Boser and B. A. Wooley, “The Design of Sigma-Delta Modulation Analog-to-Digital Converters,” IEEE Journal of Solid-State Circuits, vol. 23, no. 6, pp. 1298–1308, 1988. DOI: 10.1109/4.90025. (https://doi.org/10.1109/4.90025)
[2] SkyWater PDK documentation, “Device Details: 1.8 V NMOS FET and 1.8 V PMOS FET.”
https://skywater-pdk.readthedocs.io/en/main/rules/device-details.html. Accessed 15
October 2026. Online documentation is contextual; the tested model revision is identified in Appendix A.
[3] Analog Devices, “Selecting the Right CMOS Analog Switch.” https://www.analog.com/en/
resources/design-notes/selecting-the-right-cmos-analog-switch.html. (https://www.analog.com/en/resources/design-notes/selecting-the-right-cmos-analog-switch.html) Accessed 15
October 2026.
[4] M. McCarthy and A. Collins, “Ask The Applications Engineer—26: Switches and Multiplexers,” Analog Dialogue, Analog Devices. https://www.analog.com/en/resources/
analog-dialogue/articles/ask-the-applications-engineer-26.html. (https://www.analog.com/en/resources/analog-dialogue/articles/ask-the-applications-engineer-26.html) Accessed 15
October 2026.
[5] Ngspice project, Ngspice User’s Manual and control-language documentation.
https://ngspice.sourceforge.io/docs.html;https://ngspice.sourceforge.io/ngspice-control-language-tutorial.html. Accessed 15
October 2026. Experiment logs identify simulator version 46.
