Alphonsusadt/Mixed-Signal-Delta-Sigma-ADC/blocks/01_OTA/docs/Block1_OTA_Report_ID.pdf

# Laporan Teknis Blok 1

# Operational Transconductance Amplifier (OTA)

### OTA Fully Differential 1,8 V untuk Modulator Delta-Sigma Switched-Capacitor

Desain transistor-level SKY130 dan karakterisasi ngspice

Status akhir. Karakterisasi skematik pada kondisi nominal telah selesai. OTA memenuhi target gain/stabilitas yang dipilih pada TT, 1.8 V, 27 ◦C. Pengujian PVT menemukan keterbatasan besar pada bias tegangan tetap; karena itu blok ini telah dikarakterisasi, tetapi belum dapat disebut PVT-qualified atau siap tapeout.

Laporan karakterisasi final

Revisi 2 — 2 November 2026

Blok 1 - Karakterisasi OTA | Portofolio IC Mixed-Signal

### Contents

1 Ringkasan Eksekutif | 2
2 Konteks Desain dan Tujuan | 2
3 Arsitektur Transistor-Level | 3
4 Pemilihan Kompensasi dan Karakterisasi AC | 4
5 Transient Closed-Loop Small-Signal | 5
6 Large-Signal dan Slew Rate | 6
7 Arus Diam dan Daya | 7
8 Karakterisasi Noise | 7
9 CMRR dan PSRR | 8
10 Karakterisasi Stress PVT | 9
11 Adendum Revisi 2: Sensitivitas Kompensasi dan Catatan Integrasi | 11
12 Ringkasan Performa Final | 12
13 Penilaian Desain dan Penutupan Blok | 13
A Catatan Reproducibility | 13

### Riwayat Revisi

Rev. Tanggal | Perubahan
1 | – | Karakterisasi nominal final dan uji stress PVT dengan bias tetap.
2 | 2 Nov 2026 Catatan multiplicity MIM diselesaikan (Bagian 3.2); ditambahkan adendum
| | sensitivitas kompensasi dan catatan integrasi (Bagian 11). Tidak ada metrik nominal Revisi 1 yang diubah.

### 1 Ringkasan Eksekutif

Laporan ini menutup blok analog pertama pada portofolio mixed-signal: sebuah operational transconductance amplifier fully differential menggunakan MOS 1,8-V SKY130. Desain dikarakterisasi pada level transistor menggunakan Xschem/ngspice. Desain nominal menggunakan kompensasi kapasitor MIM langsung (direct-C) dengan parameter skematik MF=80 serta beban keluaran eksternal 20 pF pada setiap sisi.
Pada kondisi nominal TT / 1.8 V / 27 ◦C, OTA menghasilkan gain DC 69.34 dB, unity-gain frequency (UGF) 3.153 12 MHz, dan phase margin 61.3704◦
| | . Pengujian closed-loop small-signal menghasilkan
rise time 10–90% sebesar 56.19 ns, settling 1% sebesar 186.86 ns, dan settling 0,1% sebesar 294.80 ns. Pengujian large-signal memberikan slew rate positif sekitar 5.06 V/µs dan negatif sekitar 4.97 V/µs. Daya DC nominal adalah 11.59 mW.

Karakterisasi noise, common-mode rejection, dan supply rejection juga dilakukan. Integrated input-referred noise pada rentang 1 Hz–25 kHz adalah sekitar 42.07 µVrms. Nilai CMRR dan PSRR nominal yang sangat tinggi ditafsirkan secara hati-hati karena simetri skematik ideal dapat menekan error diferensial hingga mendekati batas numerik simulator.

Temuan desain terpenting berasal dari PVT stress test. Dengan Vbias nominal tetap sebesar 0.507 621 V, operating point runtuh pada kondisi ekstrem supply, temperatur, dan process. Kesimpulan engineering-nya jelas: diperlukan bias/current reference yang mengikuti PVT sebelum OTA dapat dianggap robust untuk implementasi silikon.

### 2 Konteks Desain dan Tujuan

OTA dirancang sebagai core analog untuk modulator delta-sigma switched-capacitor orde dua dengan frekuensi sampling nominal 4 MHz dan oversampling ratio 80. Band sinyal nominal yang digunakan pada integrasi noise adalah
| | BW = fs 2 OSR = 4 MHz
| | 160
= 25 kHz. | (1)

Prioritas karakterisasi meliputi gain frekuensi rendah, stabilitas closed-loop, kecepatan settling relatif terhadap periode sampling, keseimbangan large-signal, noise, dan pengujian robustness terhadap PVT.

Table 1: Kondisi karakterisasi nominal.

Parameter | Nilai | Keterangan
Supply VDD | 1.8 V | Device SKY130 1,8 V
Input common mode | 0.4 V | Vin,p = Vin,n saat DC
Bias Vbias | 0.507 621 V | Bias nominal tetap
Kontrol CMFB Vcmfb1 | 0.9 V | Bias eksternal testbench
Beban output | 20 pF/sisi | Kapasitor beban eksternal
Process/temperatur | TT / 27 ◦C Kondisi nominal

### 3 Arsitektur Transistor-Level

### 3.1 Skematik awal desain

Proses desain dimulai dari skematik OTA fully differential awal yang ditunjukkan pada Gambar 1. Implementasi baseline ini memuat differential pair PMOS, jalur gain/current mirror, device output komplementer, transistor pengendali common-mode, serta dua cabang kompensasi yang dikendalikan oleh Vbz (Vbz_L dan Vbz_R) di sekitar jaringan kompensasi sisi output. Pada skematik awal, kapasitor MIM kompensasi juga sempat dieksplorasi dengan scaling yang jauh lebih besar (pada tangkapan desain terlihat MF=1000).

Skematik baseline ini sengaja dipertahankan di laporan karena merupakan titik awal nyata proses desain, bukan hanya menampilkan konfigurasi akhir yang berhasil. Hasil karakterisasi berikutnya menunjukkan bahwa susunan compensation/nulling awal belum memberikan trade-off stabilitas dan performa yang diinginkan. Karena itu desain kemudian disederhanakan menjadi varian final OTA_experiment: cabang nulling dihilangkan dan kompensasi direct-C dituning ulang hingga MF=80.


Figure 1: Skematik OTA baseline awal di Xschem sebelum penyederhanaan kompensasi direct-C. Cabang yang dikendalikan Vbz dan setting kapasitor kompensasi awal yang besar dipertahankan sebagai bagian dari riwayat desain.

### 3.2 Arsitektur final yang dikarakterisasi

OTA final terdiri dari input differential pair PMOS, device internal untuk gain/current mirror, device output komplementer, dan device PMOS untuk pengendalian common-mode. Kapasitor kompensasi langsung dihubungkan dari kedua output menuju node internal berimpedansi tinggi. Eksperimen nulling branch yang digunakan pada tahap awal tidak dipakai pada skematik eksperimen final.

Table 2: Ukuran transistor pada OTA_experiment.

Device | Tipe | W (µm) L (µm)
M1, M2 | PMOS | 120 | 1.2
M3, M4 | NMOS 8 | 2
M5, M6 | NMOS 20 | 2
M7, M8 | PMOS | 30 | 2
M9, M10 | PMOS | 300 | 1
M11, M12 NMOS 200 | 1
M13 | PMOS | 60 | 1.2

Konfigurasi kompensasi final menggunakan dua kapasitor MIM SKY130 dengan parameter skematik MF=80. Catatan multiplicity terselesaikan (Revisi 2). Uji kapasitansi AC khusus membandingkan simbol MIM Xschem dengan kapasitor referensi ideal 1 pF. Simbol menuliskan MF=N dan m=N sekaligus ke netlist; model MIM SKY130 mengabaikan MF, dan hanya m yang mengalikan kapasitansi. Satu unit (W = L = 1 dengan scale netlist 10⁻⁶
) terukur 2.645 fF. Dengan demikian MF=80 bernilai 211.6 fF per kapasitor kompensasi, MF=100 bernilai 264.5 fF, dan MF=1000 bernilai 2.645 pF; tidak terjadi multiplicity ganda. Referensi kalibrasi terbaca 1000.00 fF. Ini adalah pengukuran model nominal (status: terukur, belum final).

### 4 Pemilihan Kompensasi dan Karakterisasi AC

Konfigurasi kompensasi awal menghasilkan phase margin yang tidak mencukupi. Pendekatan direct-C kemudian diuji dengan meningkatkan scaling kapasitor MIM. Konfigurasi final dipilih karena merupakan titik uji yang memenuhi target stabilitas nominal sekitar 60◦ dengan bandwidth yang masih berada pada orde MHz.

Untuk eksitasi diferensial,
Av(f) = Vout,p − Vout,n

Vin,p − Vin,n

. | (2)

Tanda gain dinormalisasi pada post-processing agar phase margin dapat diukur konsisten pada crossing 0 dB.

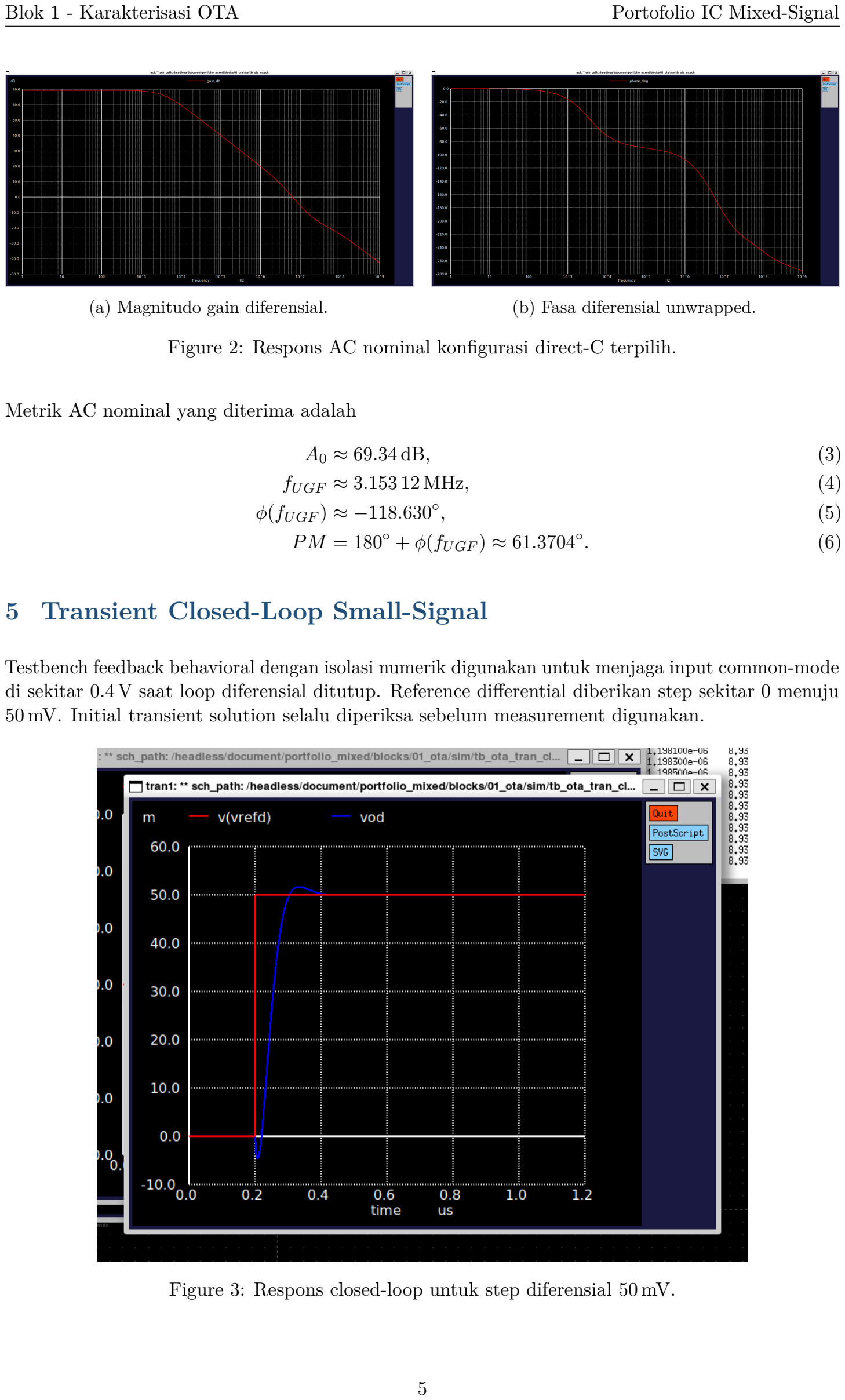
[picture p59: page 6]

(a) Magnitudo gain diferensial. | (b) Fasa diferensial unwrapped.

Figure 2: Respons AC nominal konfigurasi direct-C terpilih.

Metrik AC nominal yang diterima adalah

A0 ≈ 69.34 dB, | (3)
fUGF ≈ 3.153 12 MHz, | (4)
ϕ(fUGF ) ≈ −118.630◦
, | (5)
PM = 180◦ + ϕ(fUGF ) ≈ 61.3704◦
. | (6)

### 5 Transient Closed-Loop Small-Signal

Testbench feedback behavioral dengan isolasi numerik digunakan untuk menjaga input common-mode di sekitar 0.4 V saat loop diferensial ditutup. Reference differential diberikan step sekitar 0 menuju 50 mV. Initial transient solution selalu diperiksa sebelum measurement digunakan.

Figure 3: Respons closed-loop untuk step diferensial 50 mV.

Table 3: Hasil transient small-signal closed-loop.

Metrik | Hasil
Rise time 10–90% | 56.1867 ns
Settling 1% | 186.859 ns
Settling 0,1% | 294.795 ns
Overshoot | 3.570 43 %
Droop output common-mode | 2.3165 mV
Output diferensial final | sekitar 49.893 mV

Untuk clock sampling 4 MHz, satu periode penuh adalah 250 ns. Settling 1% lebih cepat dari satu periode, tetapi settling 0,1% lebih lambat. Karena sistem switched-capacitor dua fasa dapat menyediakan jendela settling yang lebih pendek lagi, timing harus diperiksa ulang ketika OTA diintegrasikan ke integrator SC final.

### 6 Large-Signal dan Slew Rate

Reference closed-loop diperbesar menjadi sekitar 0 menuju 300 mV untuk mengukur perilaku pengisian/pengosongan large-signal.


Figure 4: Respons diferensial large-signal untuk karakterisasi slew rate.

Hasil yang valid adalah

SR+ ≈ 5.059 60 V/µs, | (7)
SR− ≈ 4.970 22 V/µs. | (8)

Nilai positif dan negatif hampir simetris. Pada event large-signal, output common-mode bergerak kira-kira dari 0.861 V hingga 0.920 V.

### 7 Arus Diam dan Daya

Pada operating point nominal seimbang,

IDD = 6.438 659 mA | (9)

dan
PDC = VDDIDD ≈ 11.589 59 mW. | (10)


Figure 5: Pengukuran arus diam dan daya DC nominal.

Nilai daya ini masih dapat diterima untuk proof-of-concept portofolio analog, tetapi relatif besar bila target akhir diarahkan ke converter berdaya rendah. Ukuran output stage dan strategi bias dapat menjadi sasaran optimasi berikutnya.

### 8 Karakterisasi Noise

Noise differential dianalisis dari 1 Hz hingga 25 kHz, sesuai baseband nominal untuk sampling 4 MHz dan OSR 80. Source AC diferensial 1 V digunakan agar ngspice dapat menghitung output noise dan input-referred noise.


Figure 6: Operating point dan hasil integrated noise.

Hasil integrasi:

vn,out,rms ≈ 82.187 23 mVrms, | (11)
vn,in,rms ≈ 42.073 35 µVrms. | (12)

Input-referred noise merupakan angka blok yang lebih berguna. Pada level sistem, angka ini perlu dibandingkan dengan kT /C switched-capacitor, quantization noise, full-scale signal, dan target dynamic range.

### 9 CMRR dan PSRR

CMRR diuji dengan memberikan eksitasi AC identik ke kedua input dan mengamati output diferensial. Pada 1 Hz, common-mode gain sekitar −156.854 dB, sehingga CMRR nominal terhitung sekitar 226.194 dB.

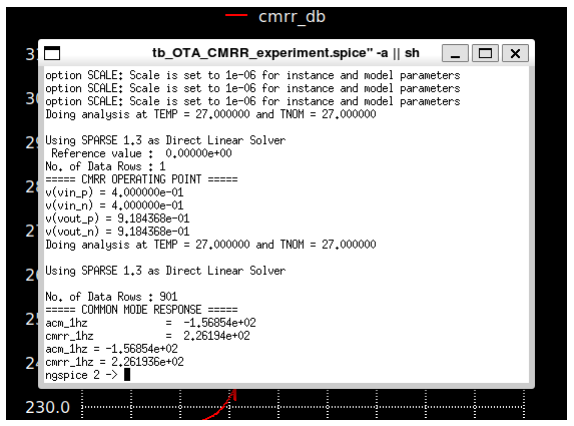
[picture p60: figure]
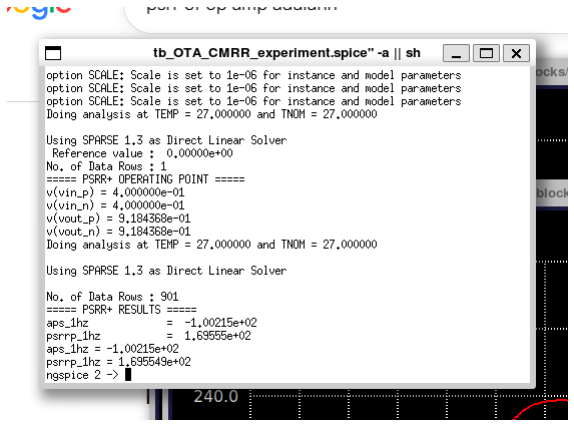
[picture p61: figure]

(a) Hasil CMRR nominal. | (b) Hasil PSRR+ nominal.

Figure 7: Pengukuran rejection pada level skematik nominal.

Untuk PSRR+, coupling supply ke output diferensial pada 1 Hz sekitar −100.215 dB, dengan PSRR+

nominal terhitung sekitar 169.555 dB. Pada PSRR-, simetri skematik ideal membuat coupling diferensial berada di bawah numerical floor yang sengaja diberikan untuk menghindari log(0); karena itu tidak ada nilai PSRR- finite yang diklaim sebagai nilai fisik.

Nilai CMRR/PSRR yang sangat tinggi di atas adalah indikator simetri skematik nominal, bukan prediksi silikon. Mismatch device, coupling jaringan bias, parasitik interkoneksi, beban asimetris, dan gradient layout akan menurunkan rejection. Monte Carlo dan post-layout extraction diperlukan untuk mendapatkan angka implementasi yang realistis.

### 10 Karakterisasi Stress PVT

### 10.1 Metode

Pengujian PVT mempertahankan bias nominal tetap Vbias = 0.507 621 V agar sensitivitas operating point terhadap process, voltage, dan temperature terlihat secara langsung. Tujuh titik diuji: nominal TT, dua ekstrem supply, dua ekstrem temperatur, serta SS dan FF pada supply/temperatur nominal.

Sebuah corner dinyatakan GAGAL jika output common-mode runtuh mendekati rail atau amplifier kehilangan gain frekuensi rendah yang bermakna. Jika operating point sudah gagal, angka UGF atau fasa numerik dari simulator tidak digunakan sebagai metrik amplifier yang valid.

Table 4: Hasil stress PVT dengan bias nominal tetap.

Process | VDD | Temp. | VOCM | A0 | IDD | Daya | Status / pengamatan
| (V) | (◦C) | (V) | (dB)
TT | 1.80 | 27 | 0.9184 | 69.34 | 6.439 mA | 11.590 mW | LULUS
TT | 1.62 | 27 | 1.6129 | -57.23 | 16.7 nA | 27.1 nW | GAGAL; rail atas
TT | 1.98 | 27 | 0.1306 | -103.04 | 14.44 mA | 28.58 mW | GAGAL; rail bawah
TT | 1.80 | -40 | 1.7978 | -61.26 | 31.3 nA | 56.3 nW | GAGAL; rail atas
TT | 1.80 | 125 | 0.1450 | -82.86 | 10.02 mA | 18.04 mW | GAGAL; rail bawah
SS | 1.80 | 27 | 0.1010 | -90.19 | 9.513 mA | 17.12 mW | GAGAL; rail bawah
FF | 1.80 | 27 | 1.7892 | -4.04 | 0.810 µA | 1.459 µW | GAGAL; rail atas


(a) TT, -40◦C | (b) TT, 125◦C | (c) TT, 1,62 V


(d) TT, 1,98 V | (e) SS, 1,8 V | (f) FF, 1,8 V

Figure 8: Contoh operating point yang gagal pada stress PVT fixed-bias.

### 10.2 Diagnostik bias terhadap temperatur

Sweep bias terpisah dilakukan sebagai eksperimen diagnostik. Pada TT / 1.8 V, sweep DC menemukan sekitar 0.470 423 V pada -40◦C dan 0.591 558 V pada 125◦C saat kurva sweep melintasi common-mode output nominal. Namun pada titik dingin, crossing tersebut tidak dapat direproduksi sebagai standalone AC operating point yang robust; standalone solver memilih equilibrium berbeda. Path dependence ini menunjukkan bahwa sekadar mengganti bias dengan angka yang dituning manual tidak cukup untuk membuktikan robustness PVT.

Implikasi desain yang benar adalah membangun jaringan bias/current-reference yang secara fisik memiliki perilaku PVT terkontrol, lalu mengulang seluruh karakterisasi.

### 11 Adendum Revisi 2: Sensitivitas Kompensasi dan Catatan Integrasi

Adendum ini mencatat dua pemeriksaan yang dilakukan setelah blok dibekukan. Adendum tidak mengubah metrik nominal pada bagian sebelumnya. Status semua hasil di bawah: terukur, belum final (OTA saja, kontrol common-mode ideal, 20 pF per sisi, TT / 1.8 V / 27 ◦C).

### 11.1 Kapasitansi kompensasi: MF=80 terhadap MF=100

Testbench AC pada Bagian 4 dipakai ulang tanpa perubahan. Satu-satunya perbedaan antara dua run adalah salinan skematik OTA dengan MF kedua kapasitor kompensasi diubah dari 80 menjadi
100. Run MF=80 mereproduksi nilai Block 1 (gain, UGF, dan phase margin) sampai digit yang dicetak.

Table 5: Pengaruh kapasitansi kompensasi (semua kondisi lain identik).

Metrik | MF=80 (211.6 fF) MF=100 (264.5 fF) Perubahan
Gain DC A0 | 69.34 dB | 69.34 dB | 0.00 dB
UGF | 3.1531 MHz | 2.7111 MHz | −14.0%
Fase pada UGF | −118.63◦ | −113.39◦
Phase margin | 61.37◦ | 66.61◦ | +5.24◦
Gain pada 100 kHz | 30.03 dB | 28.65 dB
Gain pada 1 MHz | 10.02 dB | 8.65 dB

Skala UGF ∝ 1/Cc memperkirakan perubahan −20% untuk kenaikan kapasitansi 25%; perubahan terukur adalah −14%, setara eksponen empiris sekitar −0,68 antara kedua titik ini. UGF karenanya tidak ditentukan oleh Cc saja.

Dua pengamatan lain dari harness yang sama: (i) menaikkan Vbz dari 1.5 V ke 1.8 V memberi hasil identik pada presisi yang dicetak, termasuk titik operasi DC; penyebabnya belum diselidiki. (ii) Menetapkan Vbias = 0.58 V mendorong kedua keluaran ke sekitar 1.79 V (gain −38,5 dB, tanpa perpotongan unity-gain). Pada harness ini Vcmfb1 adalah sumber tetap sehingga common mode keluaran tidak diregulasi; run itu merupakan batas harness dan bukan karakterisasi OTA pada bias tersebut.

### 11.2 Hubungan dengan OTA pada netlist modulator

Netlist modulator tingkat transistor (subcircuit S1_OTA_CMFB dan S2_OTA_CMFB, setara skematik repositori OTA_CMFB) memakai penamaan transistor yang sama dengan blok ini, tetapi bukan sizing OTA_experiment:

Table 6: Sizing W/L dalam µm: OTA yang dikarakterisasi terhadap netlist modulator.

Perangkat | OTA_experiment (laporan ini) Netlist modulator
M1, M2 (PMOS) | 120 / 1.2 | 240 / 0.6
M3, M4 (NMOS) | 8 / 2 | 8 / 2
M5, M6 (NMOS) | 20 / 2 | 40 / 2
M7, M8 (PMOS) | 30 / 2 | 60 / 2
M9, M10 (PMOS) | 300 / 1 | 60 / 1
M11, M12 (NMOS) | 200 / 1 | 80 / 1
M13 (PMOS) | 60 / 1.2 | 480 / 1.2
Cabang seri Vbz (NMOS 5/5) dihapus | ada, seri dengan Cc
Kapasitor kompensasi | MF=80 (211.6 fF) | MF=100 (264.5 fF)

Skematik repositori OTA_CMFB memuat MF=1000; netlist modulator hasil generate memakai MF=100. Metrik pada laporan ini karenanya hanya menggambarkan OTA_experiment. Metrik itu belum diukur untuk OTA yang dipakai pada netlist modulator, dan hasil closed-loop dari netlist tersebut (laporan Block 5) bukan bukti bagi metrik yang dilaporkan di sini. Karakterisasi AC OTA modulator dengan SC-CMFB tertutup pada bias loop-nya tetap menjadi pekerjaan terbuka.

### 12 Ringkasan Performa Final

Table 7: Metrik nominal final Blok-1 OTA.

Metrik | Hasil | Interpretasi
DC gain | 69.34 dB | Valid nominal
UGF | 3.15312 MHz | Valid nominal
Phase margin | 61.3704◦ | Loop nominal stabil
Rise time | 56.1867 ns | Step closed-loop 50 mV
Settling 1% | 186.859 ns | Step closed-loop 50 mV
Settling 0,1% | 294.795 ns | Step closed-loop 50 mV
Overshoot | 3.57043% | Small-signal
SR+ / SR− | 5.0596 / 4.9702 V/µs | Step 300 mV
Arus diam | 6.438659 mA | TT / 1,8 V / 27◦C
Daya DC | 11.58959 mW | TT / 1,8 V / 27◦C
Input-referred noise 42.07335 µVrms | 1 Hz–25 kHz
Output noise | 82.18723 mVrms | 1 Hz–25 kHz
CMRR @ 1 Hz | 226.194 dB | Nominal, dibatasi simetri
PSRR+ @ 1 Hz | 169.555 dB | Nominal, sensitif simetri
PSRR- @ 1 Hz | Numerical floor | Tidak mengklaim angka fisik finite
PVT fixed-bias | Hanya nominal yang lulus Bias perlu redesign

### 13 Penilaian Desain dan Penutupan Blok

Blok ini menunjukkan workflow desain analog yang lengkap, bukan hanya satu Bode plot. OTA diperiksa dari operating point, kompensasi diiterasi, respons closed-loop diverifikasi, large-signal diukur, konsumsi daya dan noise dihitung, rejection diuji, dan desain sengaja diberikan stress di luar kondisi nominal.

Kesimpulan akhir dibagi menjadi dua pernyataan:

1. Karakterisasi nominal selesai. Pada TT / 1.8 V / 27 ◦C, OTA direct-C terpilih merupakan blok yang valid dan telah memiliki data gain, bandwidth, phase margin, settling, slew rate, power, noise, CMRR, dan PSRR.
2. PVT qualification belum tercapai. Bias tegangan eksternal tetap tidak robust pada stress process, supply, dan temperatur yang diuji. Bias/current-reference perlu didesain ulang sebelum OTA dianggap siap tapeout.

Dengan demikian, Blok 1 dapat di-freeze untuk melanjutkan pengembangan arsitektur sistem dan portofolio, selama keterbatasan PVT tetap dicatat sebagai requirement implementasi yang belum terselesaikan. Blok berikutnya boleh menggunakan model OTA nominal, sementara revisi yang diarahkan ke silikon harus menambahkan bias PVT-aware, Monte Carlo mismatch, parasitik hasil ekstraksi, dan re-characterization setelah layout.

### A Catatan Reproducibility

Paket laporan menyertakan CSV metrik nominal dan tujuh titik stress PVT. Gambar pada laporan berasal langsung dari run Xschem/ngspice yang telah divalidasi. Karakterisasi menggunakan testbench terpisah untuk AC, transient closed-loop, slew rate, power, noise, CMRR, PSRR+, PSRR-, dan PVT.

Untuk revisi selanjutnya, urutan sign-off yang disarankan adalah: generate ulang netlist, audit multiplicity kapasitor MIM (selesai pada Revisi 2, Bagian 3.2), rekonsiliasi OTA pada netlist modulator dengan OTA yang dikarakterisasi (Bagian 11.2), ulangi karakterisasi nominal, ulangi PVT setelah bias network didesain ulang, lalu tambahkan Monte Carlo mismatch dan post-layout extraction.
