Alphonsusadt/Mixed-Signal-Delta-Sigma-ADC/docs/Block2_SC_CMFB_ID.pdf

## CATATAN PERANCANGAN / BLOK 02

# Dari Satu Transmission Gate Menjadi Sistem Umpan Balik Nyata

## Perancangan dan Verifikasi Jaringan Switched-Capacitor Common-Mode Feedback Berbasis 8 TG

Implementasi transistor-level, integrasi OTA, dan pelajaran awal pengujian PVT

Status bukti: closed-loop nominal telah didemonstrasikan; ketahanan PVT dengan bias tetap dan timing 4 MHz masih perlu diverifikasi.

SKY130 / Xschem / ngspice | October 2026

Block 02 / SC-CMFB | Mixed-Signal IC Portfolio

## Daftar Isi

1 Mengapa pekerjaan ini dimulai dari satu saklar | 2
2 Membangun transmission gate yang bisa digunakan berulang | 2
3 Ketika delapan TG membentuk SC-CMFB | 3
4 Dari jaringan mandiri menjadi umpan balik OTA yang nyata | 5
5 PVT: ketika keberhasilan nominal belum cukup | 7
6 Eksperimen bias pertama: mengubah Vcs | 8
7 Apa yang sudah tercapai dan apa yang belum | 8
Referensi dan catatan sumber data | 9

## Abstrak

Sebuah transmission gate (TG) terlihat seperti titik awal yang sangat sederhana untuk sebuah rancangan analog. Namun, dalam pekerjaan ini TG menjadi unit dasar bagi sistem yang lebih besar: jaringan switched-capacitor common-mode feedback (SC-CMFB) yang tersusun dari delapan saklar dan empat kapasitor untuk sebuah operational transconductance amplifier (OTA) diferensial penuh. Pengerjaan dilakukan bertahap, mulai dari desain saklar transistor-level, pembuatan simbol, verifikasi mandiri, identifikasi simpul keluaran tahap pertama, integrasi broken-loop, hingga simulasi closed-loop. Titik balik terpenting terjadi ketika simpul common-mode tahap pertama dibedakan dari output akhir OTA. Sweep DC tiga titik menghasilkan sensitivitas kontrol tahap pertama sekitar −118,54V/V, mendukung arah umpan balik negatif yang diinginkan. Pada TT, 1.8 V, dan 27 °C, simulasi closed-loop 100 µs menghasilkan common-mode tahap pertama 0.930 101 V, dibandingkan referensi 0.929 274 2 V, dengan ripple sekitar 0.470 mV puncak-ke-puncak. Tegangan kontrol CMFB rata-rata mencapai 0.900 678 V. Tujuh pengujian PVT awal mengungkap keterbatasan penting: bias eksternal tetap belum mampu mempertahankan titik operasi ketika catu daya dan temperatur berubah. Karena itu, hasil pekerjaan ini merupakan prototipe fungsional nominal dengan kebutuhan lanjutan yang jelas pada sistem bias dan verifikasi clock lebih cepat.
Kata kunci: transmission gate; switched-capacitor; common-mode feedback; OTA diferensial; SKY130; PVT; verifikasi mixed-signal.

## 1 Mengapa pekerjaan ini dimulai dari satu saklar

Sistem yang ingin dibangun pada akhirnya adalah modulator delta-sigma orde dua berbasis switched-capacitor. Di dalam sistem semacam ini, OTA perlu memproses komponen diferensial tanpa membiarkan tegangan common-mode pada simpul internalnya bergeser tanpa kendali. Cara yang tampak paling singkat ialah langsung memasang blok umpan balik. Akan tetapi, kami memilih jalan yang lebih mudah diaudit: memahami saklarnya dahulu, memastikan kapan ia menghantarkan sinyal, lalu membangun jaringan yang memanfaatkan perpindahan muatan untuk melakukan koreksi.
Dua keluaran tahap pertama OTA dinyatakan sebagai VO1,A dan VO1,B. Besaran common-mode dan diferensialnya adalah

VO1,CM =

VO1,A + VO1,B
2
, | VO1,D = VO1,A − VO1,B. | (1)

Sementara itu, common-mode keluaran akhir OTA harus ditulis terpisah:

Vout,CM =

Vout,p + Vout,n
| 2
| . | (2)

Perbedaan ini ternyata bukan sekadar soal penamaan. Jaringan SC-CMFB yang dipakai justru membaca simpul tahap pertama; keluaran final OTA adalah besaran lanjutan yang harus diamati, tetapi bukan tempat sensing yang tepat untuk rangkaian ini.
Referensi tahap pertama yang dikalibrasi adalah VO1,ref = 0.929 274 2V. Nilainya sengaja tidak disamakan begitu saja dengan common-mode keluaran akhir yang mendekati 0.9 V. Referensi ini diperoleh dari sweep OTA nominal, bukan hanya dari asumsi VDD/2.

## 2 Membangun transmission gate yang bisa digunakan berulang

### 2.1 NMOS dan PMOS sebagai jalur sinyal paralel

Sel TG terdiri atas satu NMOS dan satu PMOS dengan terminal sinyal yang dipasang paralel, sedangkan gate dikendalikan clock komplementer. Ukuran nominal pada model SKY130 1,8 V adalah Wn/Ln = 2/0.15 dan Wp/Lp = 4/0.15, dengan satuan geometri µm. Ukuran ini mendokumentasikan desain yang disimulasikan, bukan klaim telah optimal pada layout. Saat ϕ = VDD dan ϕ = 0, kedua transistor diperintahkan aktif. Ketika kedua level dibalik, keduanya dinonaktifkan. Pada pendekatan orde pertama, resistansi ON gabungannya adalah

Ron,TG ≃

(
1
Ron,n

+

1
Ron,p

)−1
. | (3)

Dalam praktiknya nilai resistansi tidak konstan karena VGS, tegangan ambang, dan body effect berubah mengikuti level sinyal. NMOS membantu jalur konduksi pada sisi tegangan rendah, sedangkan PMOS melengkapinya mendekati rail atas.


(a) Sel TG level transistor. | (b) Simbol Xschem yang dapat digunakan ulang.
Figure 1: Proses perancangan berawal dari satu saklar fisik lalu berubah menjadi modul yang bisa direplikasi. Gambar adalah versi berlatar terang dari tangkapan layar Xschem yang diberikan.

### 2.2 Saklar harus selesai menghantarkan sebelum fase berganti

Dalam rangkaian switched-capacitor, TG memiliki waktu terbatas untuk mengisi atau mengosongkan kapasitor. Jika lintasannya didekati menggunakan satu rangkaian RC, maka

|VC(t) − V∞| = |VC(0) − V∞| exp(
−
| t

ReqCeq )
, ton ≥ ReqCeq ln ¹
ϵ
. | (4)

Sebagai contoh, jika kapasitor nominal 1 pF, durasi ON 300 ns, dan sisa error yang ditoleransi 0,1%, pendekatan sederhana ini mensyaratkan Req ≲ 43.4 kΩ. Angka tersebut merupakan perkiraan untuk screening, bukan pengukuran resistansi ON TG. Parasitik dan sifat saklar yang nonlinear belum dimasukkan.
TG tunggal lebih dulu diuji fungsi clock dan transfer sinyalnya sebelum disalin menjadi banyak instance. Urutan ini sengaja dipertahankan dalam dokumentasi: kesalahan polaritas atau wiring pada satu simbol dapat menjalar menjadi delapan kesalahan jika langsung direplikasi. Pengukuran lengkap resistansi ON, kebocoran PVT, dan charge injection tetap diperlukan untuk verifikasi akhir.

## 3 Ketika delapan TG membentuk SC-CMFB

### 3.1 Empat kapasitor dan dua fase aktif

Simbol TG yang telah diperiksa kemudian digunakan delapan kali dan dihubungkan dengan empat kapasitor nominal 1 pF. Implementasi Xschem menggunakan ϕ1, ϕ1
, ϕ2, ϕ2

. Simpul
eksternalnya mencakup Vcs, Vcmo, dua keluaran tahap pertama OTA, dan tegangan kendali CMFB.


Figure 2: Schematic jaringan SC-CMFB dengan delapan TG dan empat kapasitor (Xschem). Sisi kiri dan kanan bekerja dengan pasangan sinyal tahap pertama OTA.

Clock standalone menggunakan periode 1 µs. Fase ϕ1 aktif kurang lebih dari 100 ns sampai 402 ns, sedangkan ϕ2 dari 600 ns sampai 902 ns. Terdapat selang non-overlap sekitar 198 ns di antara kedua fase. Huruf “b” pada PHI1B atau PHI2B berarti bar, yakni sinyal komplemen untuk gate pasangan MOS.
Muatan pada kapasitor mengikuti Qi = CiVi

. Pada redistribusi muatan ideal, total muatan di simpul terisolasi tetap:
∑

i

CiV

sebelum
i | =

∑

i

CiV

sesudah
i
. | (5)

Untuk konfigurasi simetris dengan kapasitor setara, hasil simulasi mendekati hubungan:

VCMFB ≈ Vcs + (VO1,CM − Vcmo) + εSC, | (6)
dengan εSC merangkum settling yang tidak sempurna, charge injection, kebocoran, dan nonidealitas lain. Persamaan ini merupakan pendekatan empiris dari operating point simulasi, bukan fungsi transfer eksak hasil turunan simbolik seluruh simpul bermuatan.
Pada temperatur nominal, orde besaran noise sampling sebuah kapasitor 1 pF adalah

vn,rms ≈

√
kT
C

=

√
(1.380649 × 10−23)(300)
10−12 | ≈ 64.4 µV. | (7)
Ini hanya perkiraan kT/C per kapasitor, bukan noise total rangkaian SC-CMFB empat kapasitor maupun noise output OTA.

### 3.2 Mengapa CMFB diuji sendiri terlebih dahulu

Testbench standalone memasok tegangan referensi, empat clock, dan pasangan tegangan yang mewakili node tahap pertama. Pengujian dilakukan untuk beberapa kombinasi common-mode dan differential input. Output kendali menunjukkan respons perubahan common-mode, ripple akibat switching, dan kecenderungan menuju nilai yang berulang. Dengan cara ini, masalah pada saklar dipisahkan dari masalah bias OTA.


Figure 3: Testbench standalone SC-CMFB dengan clock, tegangan referensi, pasangan input sensing, dan keluaran kontrol.

Pengujian tersebut belum membuktikan stabilitas loop tertutup. Kesimpulannya lebih terukur: jaringan dapat menghasilkan tegangan kontrol yang bergerak sesuai perubahan common-mode dan menjalankan clock sesuai fase yang direncanakan.

## 4 Dari jaringan mandiri menjadi umpan balik OTA yang nyata

### 4.1 Kesalahan yang justru membantu: simpul sensing bukan output akhir

Pada percobaan integrasi awal, pengamatan dilakukan pada keluaran akhir OTA. Respons yang terlihat seolah memiliki tanda yang tidak sesuai. Selain itu, penelusuran netlist menemukan nama node pengukuran yang tidak terhubung, pin suplai CMFB yang belum masuk rail sesungguhnya, dan label simpul yang tertukar. Alih-alih langsung mengubah transistor, kami memisahkan node tahap pertama OTA dari keluaran finalnya.
Sweep lokal tiga titik pada sumber kontrol CMFB eksternal memberikan hasil:

Vcmfb1 (V) VO1,CM (V) Vout,CM (V)
0.8998 0.953044 | 0.378690
0.9000 0.929274 | 0.927668
0.9002 0.905628 | 1.351370

Kemiringan common-mode tahap pertama menggunakan beda tengah adalah

SOTA ≈

0.905628 − 0.953044
0.9002 − 0.8998
= | −118.54 V/V . | (8)

Keluaran final pada rentang sangat sempit tersebut justru memiliki kemiringan dengan tanda berlawanan, sekitar +2,43×10³ V/V. Inilah alasan membaca keluaran final membuat pemahaman kita tentang arah feedback keliru. Pada eksperimen awal, perhitungan operating point mandiri sempat mengeluarkan peringatan singular-node. Karena itu, angka yang dipakai di sini berasal dari tiga titik sweep DC yang berhasil, bukan nilai OP yang bermasalah.

### 4.2 Menghubungkan dua blok dengan broken-loop dahulu

Node tahap pertama OTA lalu dihubungkan ke masukan sensing SC-CMFB, sementara gate kontrol OTA tetap menerima sumber eksternal 0.900 000 V. Pada broken-loop ini, common-mode tahap pertama tercatat sekitar 0.929 257 V, dan keluaran SC-CMFB sekitar 0.898 592 V. Selisih sekitar 1.41 mV terhadap bias kontrol yang dipaksakan menjadi parameter antarmuka yang berguna sebelum feedback ditutup.
Ketika keluaran SC-CMFB akhirnya dikembalikan ke gate kontrol OTA, sumber kontrol independen dihapus. Dua perbaikan wiring menentukan keberhasilan simulasi: pin VDD SC-CMFB harus benar-benar tersambung ke supply dan node feedback harus memakai nama yang konsisten. Detail kecil netlist tersebut ternyata menentukan validitas seluruh kurva keluaran.

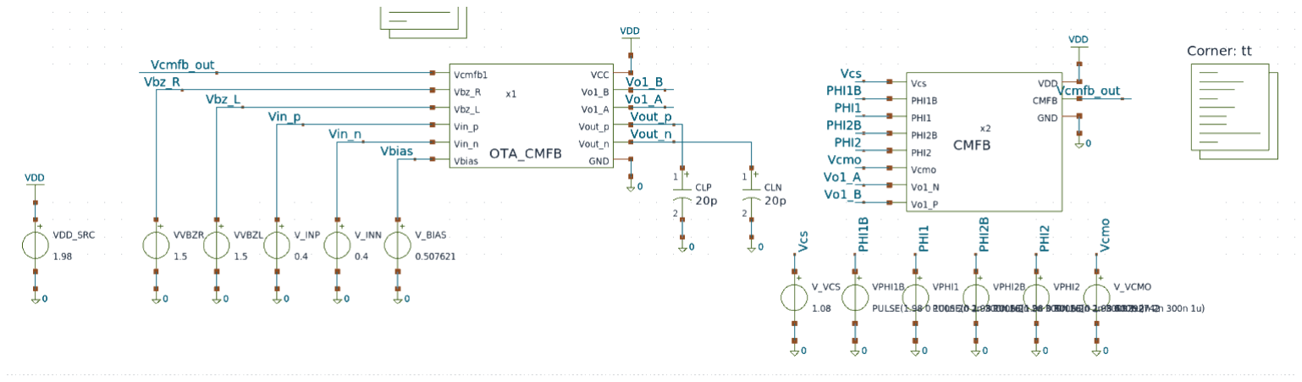
[picture p62: figure]

Figure 4: Testbench integrasi OTA–SC-CMFB pada level transistor. Node first-stage menjadi input sensing CMFB, sedangkan output CMFB kembali ke gate kontrol OTA. Screenshot menampilkan salah satu varian bias-characterization dengan VDD tinggi, bukan sumber angka tabel nominal.

### 4.3 Closed-loop nominal selama 100 µs

Pada TT / 1.80 V / 27 °C, pengukuran steady-state diambil pada interval 90 µs sampai 100 µs. Kedua input diferensial ditahan pada 0.4 V, sedangkan output akhir masing-masing diberi beban 20 pF. Karena itu, residu diferensial yang hampir nol merupakan pemeriksaan keseimbangan, bukan bukti bahwa gain diferensial atau fidelitas sinyal dinamis sudah memenuhi target. Ringkasan datanya adalah
Table 1: Pengukuran transien closed-loop nominal pada interval 10 µs terakhir.
Parameter | Rata-rata / error Ripple p-p
Common-mode tahap pertama, VO1,CM | 0.930 101 4 V 0.4696 mV
Referensi tahap pertama, VO1,ref | 0.929 274 2 V | —
Error common-mode tahap pertama | 0.8272 mV | —
Tegangan kontrol, Vcmfb,out | 0.900 677 6 V 0.6440 mV
Common-mode output akhir, Vout,CM | 0.900 133 2 V 5.6199 mV
Residu diferensial rata-rata | sekitar 0 V | —

Error terhadap referensi adalah eCM = 0.9301014 − 0.9292742 = 0.8272 mV. Perubahan rata-rata common-mode tahap pertama dan tegangan kontrol antara dua jendela 10 µs terakhir masing-masing sekitar −1.2 µV dan −1.1 µV. Ini mendukung keadaan operasi nominal yang hampir periodik. Namun, hasil tersebut belum membuktikan phase margin loop sampled-data, pemulihan terhadap gangguan, atau terpenuhinya target clock sistem 4 MHz.

## 5 PVT: ketika keberhasilan nominal belum cukup

Bias eksternal nominal dipertahankan pada Vbias = 0.507 621V, Vbz,L = Vbz,R = 1.5V, Vcs = 0.9V, dan Vcmo = 0.929 274 2V, sedangkan satu kondisi eksternal diubah setiap kali simulasi. Level HIGH clock mengikuti VDD saat supply berubah. Maka hasil ini memang uji tekanan fixed-bias, bukan karakterisasi bias generator final.

Table 2: Tujuh kondisi PVT closed-loop awal; nilai error mengacu pada target nominal, bukan keputusan kualifikasi proses.

Kondisi | VO1,CM (V) Error (mV) VCMFB (V) Vout,CM (V)
TT, 1.80 V, 27 °C | .930101 | +.827 | .900678 | .900133
TT, 1.80 V, ff40 °C | .878113 | -51.161 | .848921 | 1.504754
TT, 1.80 V, 125 °C | 1.020898 | +91.624 | .991365 | .312116
TT, 1.62 V, 27 °C | .749679 | -179.595 | .721616 | 1.455200
TT, 1.98 V, 27 °C | 1.109066 | +179.792 1.078414 | .288498
SS, 1.80 V, 27 °C | .938441 | +9.167 | .908919 | .898089
FF, 1.80 V, 27 °C | .921904 | -7.370 | .892594 | .899302

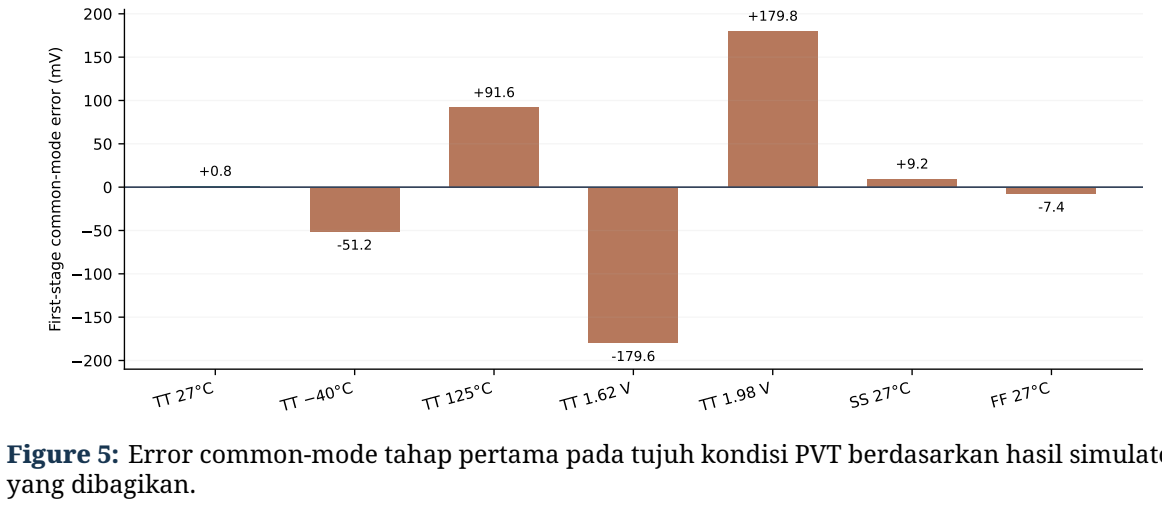
[picture p63: figure]
First-stage common-mode error (mV); yang dibagikan.

Figure 5: Error common-mode tahap pertama pada tujuh kondisi PVT berdasarkan hasil simulator

Polanya cukup jelas. SS dan FF pada supply nominal memberi deviasi yang relatif sedang, sedangkan perubahan supply sebesar ±10% menggeser common-mode tahap pertama sekitar ±180 mV. Pada supply rendah keluaran akhir mendekati rail atas; pada supply tinggi keluaran akhir justru jatuh mendekati rail bawah. Drift yang hampir nol pada operating point yang salah tidak berarti regulasi berhasil. Itu hanya menunjukkan rangkaian sudah menetap di suatu titik, bukan titik yang layak bagi kebutuhan penguatan berikutnya. Hubungan pendekatan pada Persamaan (6) masih menggambarkan arah respons CMFB pada sebagian besar pengujian. Hal tersebut merupakan petunjuk bahwa jaringan saklarkapasitor masih mengubah error common-mode menjadi sinyal kontrol, tetapi OTA dan bias tetapnya kehilangan titik keseimbangan yang diinginkan. Penyebab pastinya belum dapat dipilih antara arus transistor, batas rentang kontrol, atau headroom tanpa audit operating region.

Pengujian pada 1.98 V juga perlu dicek terhadap batas reliabilitas perangkat SKY130 1,8 V sebelum dianggap sebagai kondisi operasi kontinu yang diizinkan.

## 6 Eksperimen bias pertama: mengubah Vcs

Daripada langsung mengubah W/L M13, differential pair, atau kapasitor, kami menguji sensitivitas terhadap sumber referensi Vcs. Sweep transien otomatis mencakup nilai 0.70 V hingga 1.10 V pada tiga VDD. Screenshot terminal yang tersedia untuk dokumen ini hanya menunjukkan titik terakhir pada 1.10 V; seluruh hasil tujuh titik belum diarsipkan sebagai data numerik yang dapat dibaca mesin.
Table 3: Common-mode tahap pertama pada dua nilai Vcs, TT dan 27 °C.

VDD (V) VO1,CM, Vcs = 0.90 V VO1,CM, Vcs = 1.10 V Perubahan (mV)
1.62 | 0.749679 | 0.550443 | -199.236
1.80 | 0.930101 | 0.730138 | -199.963
1.98 | 1.109066 | 0.911039 | -198.027

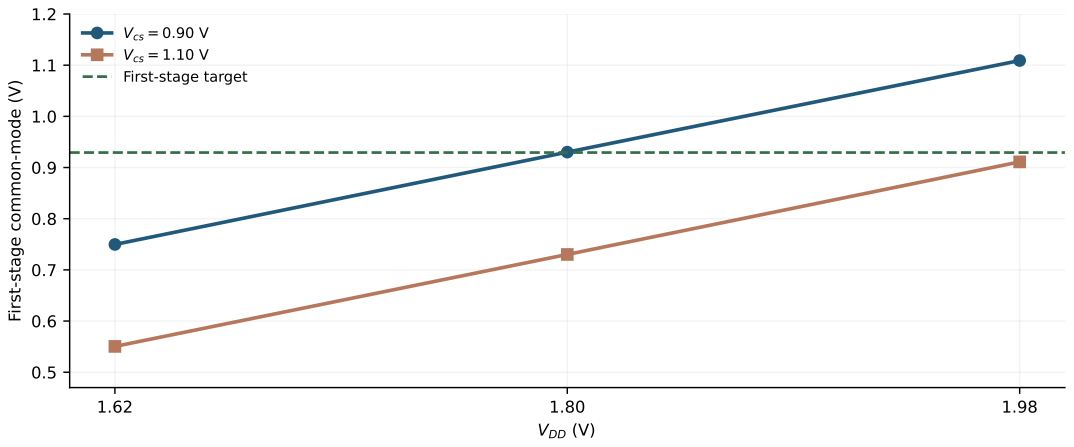
[picture p64: figure]
VDD (V); First-stage common-mode (V); Vcs = 0.90 V Vcs = 1.10 V; First-stage target

Figure 6: Perubahan common-mode tahap pertama ketika Vcs dinaikkan dari 0.90 V menjadi 1.10 V. Titik merupakan dua hasil endpoint yang tersedia, bukan seluruh kurva hasil fitting.
Dari kedua titik tersebut, ∆VO1,CM/∆Vcs ≈ −1 V/V. Interpolasi linear memberikan kandidat Vcs sekitar 0.72 V, 0.90 V, dan 1.08 V masing-masing untuk VDD 1.62 V, 1.80 V, dan 1.98 V. Angka ini masih hipotesis untuk pengujian transien dan operating region berikutnya, bukan bias optimum yang telah diverifikasi. Keberhasilan mengatur satu common-mode belum menjamin swing keluaran akhir, headroom, stabilitas, dan noise yang memadai.

## 7 Apa yang sudah tercapai dan apa yang belum

Pekerjaan ini mencapai satu tonggak yang nyata: TG tidak berhenti sebagai pasangan transistor, melainkan menjadi simbol yang bisa digunakan berulang; delapan TG dan empat kapasitor membentuk jaringan SC-CMFB; jaringan itu diuji sendiri; simpul OTA yang benar ditemukan melalui pengukuran tanda; antarmuka dua blok diperiksa dengan broken-loop; dan sistem closed-loop nominal akhirnya bekerja. Semua itu merupakan langkah rangkaian pada level schematic, bukan sekadar blok diagram yang mengandaikan fungsi telah terjadi. Pekerjaan yang masih terbuka mencakup (i) audit arus dan operating region transistor sepanjang PVT, (ii) perancangan referensi/bias yang mengikuti supply dan temperatur, (iii) pengujian sinyal diferensial dan pemulihan gangguan common-mode, (iv) analisis kestabilan sampled-data beserta clock feedthrough/noise, (v) evaluasi charge injection dan mismatch TG, dan (vi) mengubah clock SC-CMFB dari 1 MHz yang telah diperagakan menuju target sistem 4 MHz sambil mengevaluasi settling. Status saat ini adalah fungsional nominal dan telah dikarakterisasi PVT, belum siap dinyatakan sign-off silikon.

## Referensi dan catatan sumber data

1. S. Pavan, R. Schreier, dan G. C. Temes, Understanding Delta-Sigma Data Converters, edisi
ke-2, Wiley/IEEE Press, 2017, bab 7. https://doi.org/10.1002/9781119258308.ch7.
2. Schematic Xschem dan tangkapan layar terminal ngspice yang diberikan selama iterasi desain Block 2, Oktober 2026. Semua hasil numerik rangkaian berasal dari keluaran yang dibagikan; dokumen ini tidak mengklaim simulasi ngspice dijalankan ulang secara independen.
3. Semua gambar schematic berasal dari tangkapan layar Xschem yang diberikan. Versi berlatar terang hanya memperbaiki keterbacaan saat dicetak, tanpa menggambar ulang konektivitas. Grafik dibentuk kembali dari angka terminal, bukan hasil digitasi waveform.
