Alphonsusadt/Mixed-Signal-Delta-Sigma-ADC/top_level/closed_loop/results/behavioral_overview.png

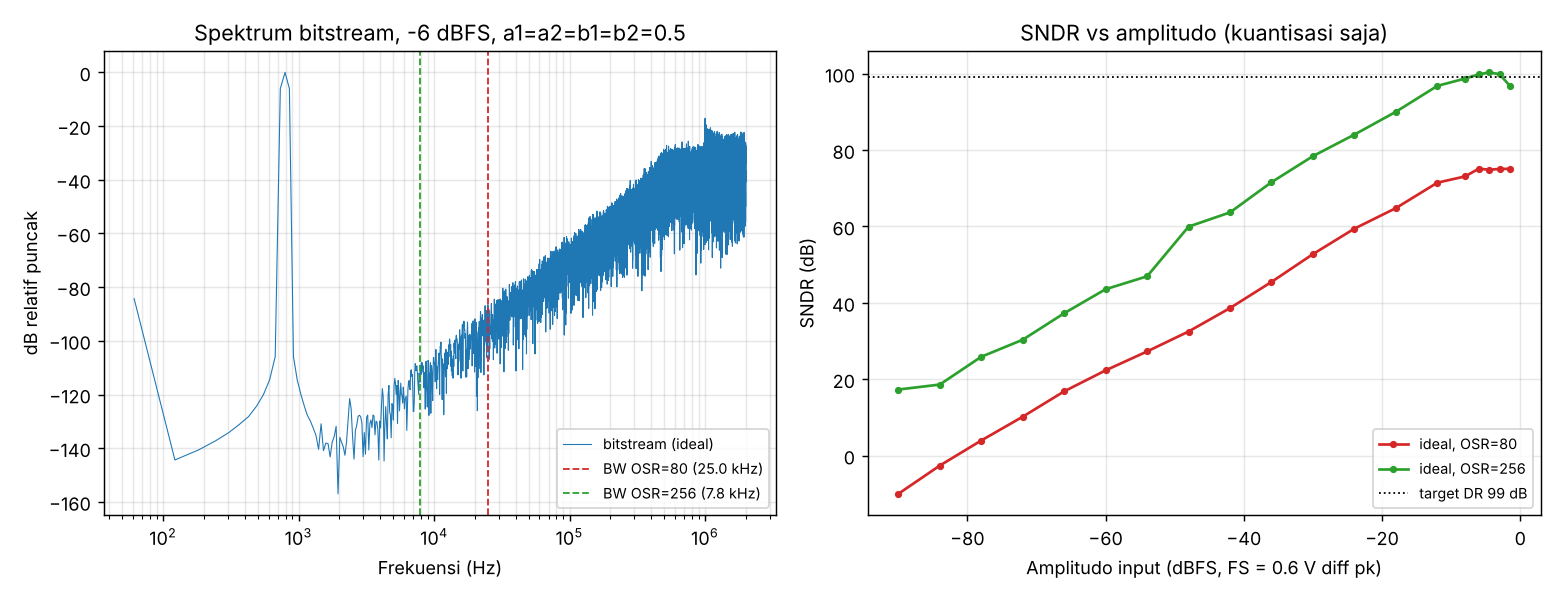
top_level/closed_loop/results/behavioral_overview.png
