Alphonsusadt/Mixed-Signal-Delta-Sigma-ADC/blocks/06_Clock_gen/docs/pvt_results_block6.md

# Block 6 (NONOV clock generator): PVT results, acceptance criteria and known limits

Generated by `tools/summarize_block6.py` from the raw CSVs in `blocks/06_Clock_gen/results/pvt/`. All numbers: pre-layout ngspice, status `MEASURED_NOT_FINAL` / `SIMULATED_NOT_FINAL_PASS`; none is a final sign-off.

## Acceptance criteria used

These are engineering screening thresholds chosen for this design. They are **not** derived from a switch-settling or comparator-timing budget; the only system-level evidence is the nominal closed-loop run below.

| # | Criterion | Threshold |
|---|---|---|
| A1 | Phases are produced in every PVT condition (5 corners x -40/27/125 C x 1.62/1.8/1.98 V = 45) | 45/45 |
| A2 | No overlap: max over time of min(phi1, phi2) | < 1 % of VDD |
| A3 | Non-overlap gap (min of both gaps) | >= 5 ns |
| A4 | Phase width (min of both phases), T/2 = 125 ns | >= 100 ns |
| A5 | Comparator clock (phi2b through 2 inverters) rises after phi2 falls and before phi1 rises | 45/45 |
| A6 | Start-up: stable width and gap within a few clock cycles after the clock starts, VDD ramp 1 and 20 us | 4 corners |

## Sweeps (A1-A4)

| Sweep | Description | Conditions | Valid | Pass A1-A4 | Gap min..max (ns) | Min width (ns) | Max overlap (% VDD) |
|---|---|---|---|---|---|---|---|
| `baseline_fixed_bias` | fixed ideal bias VBN 0.70 / VBP 0.71 V | 45 | 35 | 17/45 | 1.94 .. 91.76 | 32.9 | 0.031 |
| `replica_ideal_iref` | replica-diode bias, ideal reference current | 45 | 45 | 45/45 | 12.09 .. 16.47 | 108.4 | 0.031 |
| `generator_ideal_R` | resistor-reference generator, ideal R (no tempco) | 45 | 45 | 45/45 | 11.21 .. 18.73 | 106.2 | 0.031 |
| `generator_pdk_R_no_tc` | generator with SKY130 poly resistor (its tempco not applied by ngspice) | 45 | 45 | 45/45 | 11.34 .. 18.85 | 106.0 | 0.031 |
| `generator_R_tc` | generator, R with tc1/tc2 of the SKY130 model (MAIN) | 45 | 45 | 45/45 | 9.99 .. 20.58 | 104.3 | 0.031 |
| `generator_R_x0p8` | generator, R x 0.8 (12 conditions) | 12 | 12 | 12/12 | 9.14 .. 15.35 | 109.5 | 0.012 |
| `generator_R_x1p2` | generator, R x 1.2 (12 conditions) | 12 | 12 | 12/12 | 13.26 .. 22.06 | 102.8 | 0.012 |

Worst cases (main sweep and others):

- `baseline_fixed_bias`: smallest gap 1.94 ns at fs/-40C/1.98V; largest gap 91.76 ns at ss/-40C/1.8V; smallest width 32.89 ns at ss/-40C/1.8V.
- `replica_ideal_iref`: smallest gap 12.09 ns at sf/27C/1.62V; largest gap 16.47 ns at fs/125C/1.98V; smallest width 108.44 ns at fs/125C/1.98V.
- `generator_ideal_R`: smallest gap 11.21 ns at sf/125C/1.98V; largest gap 18.73 ns at fs/-40C/1.62V; smallest width 106.16 ns at fs/-40C/1.62V.
- `generator_pdk_R_no_tc`: smallest gap 11.34 ns at sf/125C/1.98V; largest gap 18.85 ns at fs/-40C/1.62V; smallest width 106.01 ns at fs/-40C/1.62V.
- `generator_R_tc`: smallest gap 9.99 ns at sf/125C/1.98V; largest gap 20.58 ns at fs/-40C/1.62V; smallest width 104.31 ns at fs/-40C/1.62V.
- `generator_R_x0p8`: smallest gap 9.14 ns at sf/125C/1.98V; largest gap 15.35 ns at fs/-40C/1.62V; smallest width 109.53 ns at fs/-40C/1.62V.
- `generator_R_x1p2`: smallest gap 13.26 ns at sf/125C/1.98V; largest gap 22.06 ns at fs/-40C/1.62V; smallest width 102.83 ns at fs/-40C/1.62V.

## Main sweep: generator with tempco, per condition

| Corner | T (C) | VDD (V) | Gap (ns) | Width (ns) | Overlap (mV) | tr phi1 (ns) | Status |
|---|---|---|---|---|---|---|---|
| tt | -40 | 1.62 | 18.36 | 106.45 | 0.00 | 0.61 | MEASURED_NOT_FINAL |
| tt | -40 | 1.8 | 16.00 | 108.83 | 0.00 | 0.50 | MEASURED_NOT_FINAL |
| tt | -40 | 1.98 | 14.37 | 110.49 | 0.00 | 0.44 | MEASURED_NOT_FINAL |
| tt | 27 | 1.62 | 15.69 | 109.20 | 0.00 | 0.58 | MEASURED_NOT_FINAL |
| tt | 27 | 1.8 | 13.93 | 110.98 | 0.00 | 0.50 | MEASURED_NOT_FINAL |
| tt | 27 | 1.98 | 12.66 | 112.26 | 0.00 | 0.45 | MEASURED_NOT_FINAL |
| tt | 125 | 1.62 | 13.55 | 111.45 | 0.07 | 0.57 | MEASURED_NOT_FINAL |
| tt | 125 | 1.8 | 12.19 | 112.80 | 0.08 | 0.51 | MEASURED_NOT_FINAL |
| tt | 125 | 1.98 | 11.19 | 113.80 | 0.10 | 0.47 | MEASURED_NOT_FINAL |
| ss | -40 | 1.62 | 19.69 | 105.10 | 0.00 | 0.69 | MEASURED_NOT_FINAL |
| ss | -40 | 1.8 | 16.74 | 108.08 | 0.00 | 0.55 | MEASURED_NOT_FINAL |
| ss | -40 | 1.98 | 14.93 | 109.92 | 0.00 | 0.47 | MEASURED_NOT_FINAL |
| ss | 27 | 1.62 | 16.41 | 108.45 | 0.00 | 0.65 | MEASURED_NOT_FINAL |
| ss | 27 | 1.8 | 14.44 | 110.45 | 0.00 | 0.55 | MEASURED_NOT_FINAL |
| ss | 27 | 1.98 | 13.05 | 111.86 | 0.00 | 0.49 | MEASURED_NOT_FINAL |
| ss | 125 | 1.62 | 13.91 | 111.05 | 0.01 | 0.62 | MEASURED_NOT_FINAL |
| ss | 125 | 1.8 | 12.48 | 112.51 | 0.02 | 0.55 | MEASURED_NOT_FINAL |
| ss | 125 | 1.98 | 11.43 | 113.56 | 0.02 | 0.50 | MEASURED_NOT_FINAL |
| ff | -40 | 1.62 | 17.43 | 107.40 | 0.00 | 0.54 | MEASURED_NOT_FINAL |
| ff | -40 | 1.8 | 15.35 | 109.51 | 0.00 | 0.46 | MEASURED_NOT_FINAL |
| ff | -40 | 1.98 | 13.84 | 111.04 | 0.00 | 0.41 | MEASURED_NOT_FINAL |
| ff | 27 | 1.62 | 15.10 | 109.82 | 0.01 | 0.53 | MEASURED_NOT_FINAL |
| ff | 27 | 1.8 | 13.47 | 111.47 | 0.01 | 0.46 | MEASURED_NOT_FINAL |
| ff | 27 | 1.98 | 12.28 | 112.66 | 0.01 | 0.43 | MEASURED_NOT_FINAL |
| ff | 125 | 1.62 | 13.16 | 111.80 | 0.36 | 0.53 | MEASURED_NOT_FINAL |
| ff | 125 | 1.8 | 11.84 | 113.13 | 0.47 | 0.48 | MEASURED_NOT_FINAL |
| ff | 125 | 1.98 | 10.85 | 114.12 | 0.62 | 0.44 | MEASURED_NOT_FINAL |
| sf | -40 | 1.62 | 16.46 | 108.27 | 0.00 | 0.74 | MEASURED_NOT_FINAL |
| sf | -40 | 1.8 | 14.39 | 110.38 | 0.00 | 0.59 | MEASURED_NOT_FINAL |
| sf | -40 | 1.98 | 13.02 | 111.77 | 0.00 | 0.50 | MEASURED_NOT_FINAL |
| sf | 27 | 1.62 | 13.97 | 110.84 | 0.00 | 0.68 | MEASURED_NOT_FINAL |
| sf | 27 | 1.8 | 12.49 | 112.34 | 0.00 | 0.57 | MEASURED_NOT_FINAL |
| sf | 27 | 1.98 | 11.42 | 113.43 | 0.00 | 0.51 | MEASURED_NOT_FINAL |
| sf | 125 | 1.62 | 11.88 | 113.04 | 0.03 | 0.64 | MEASURED_NOT_FINAL |
| sf | 125 | 1.8 | 10.79 | 114.14 | 0.03 | 0.56 | MEASURED_NOT_FINAL |
| sf | 125 | 1.98 | 9.99 | 114.95 | 0.04 | 0.52 | MEASURED_NOT_FINAL |
| fs | -40 | 1.62 | 20.58 | 104.31 | 0.00 | 0.52 | MEASURED_NOT_FINAL |
| fs | -40 | 1.8 | 17.84 | 107.06 | 0.00 | 0.43 | MEASURED_NOT_FINAL |
| fs | -40 | 1.98 | 15.93 | 108.99 | 0.00 | 0.39 | MEASURED_NOT_FINAL |
| fs | 27 | 1.62 | 17.84 | 107.12 | 0.01 | 0.51 | MEASURED_NOT_FINAL |
| fs | 27 | 1.8 | 15.72 | 109.26 | 0.01 | 0.45 | MEASURED_NOT_FINAL |
| fs | 27 | 1.98 | 14.19 | 110.80 | 0.01 | 0.41 | MEASURED_NOT_FINAL |
| fs | 125 | 1.62 | 15.44 | 109.48 | 0.18 | 0.52 | MEASURED_NOT_FINAL |
| fs | 125 | 1.8 | 13.73 | 111.20 | 0.20 | 0.46 | MEASURED_NOT_FINAL |
| fs | 125 | 1.98 | 12.49 | 112.45 | 0.24 | 0.43 | MEASURED_NOT_FINAL |

## Comparator clock derived from phi2b (A5)

45 valid points; clock rises inside the non-overlap gap at 45/45. phi2 fall to clock rise: 0.28 .. 0.73 ns; clock rise to phi1 rise: 9.69 .. 19.68 ns. Load on the clock node is a placeholder (20 fF), not the extracted StrongARM input capacitance. Block 3 reports a worst-case integrated decision delay of 3.189 ns (standalone PVT campaign, 5 ns clock edges); the definitions and conditions of the two numbers have not been matched, so this is an indication, not a margin claim.

## Closed loop (300 mV sine, OSR 80, 4112 cycles, TT, 27 C, 1.8 V)

| Run | Configuration | SNDR (dB) | ENOB |
|---|---|---|---|
| `sine300_n4096` | ideal phases, ideal comparator clock | 75.37 | 12.23 |
| `f1_sine300_b6_n4096` | Block 6 phases (ideal bias), ideal comparator clock | 73.87 | 11.98 |
| `f5_sine300_n2_n4096` | Block 6 phases (ideal bias), comparator clock from phi2b via 2 inverters | 72.44 | 11.74 |
| `f6_sine300_b6res_n4096` | Block 6 phases with resistor-reference bias generator, comparator clock from phi2b via 2 inverters | 73.62 | 11.94 |

Single-run SNDR scatter is about +-1 dB at OSR 80, so differences between rows are not claimed as degradation or improvement. The system target was revised to about 75 dB at OSR 80.

## Known limits (not covered)

- Pre-layout only: no extraction, no parasitics; clock-node load is a placeholder.
- No Monte Carlo (device mismatch, resistor spread). The SKY130 resistor model is not corner- or tempco-active in this ngspice setup; its model tempco (tc1 = -1.47e-3 /K, tc2 = 2.7e-6 /K) was applied manually to an ideal resistor, and R spread is covered only by x0.8 / x1.2 at the extreme conditions.
- Closed loop only at the nominal point (one amplitude, one bin, one run per configuration).
- During the supply ramp phi1 follows VDD until the clock starts and phi2 can rise to a fraction of VDD; the effect on the Block 5 switches is not evaluated. The first 2-3 clock cycles after start are not nominal; they are assumed to fall inside the 5 us reset, which is a default value, not a validated requirement.
- Supply current of the generator is estimated (about 2 x I) and not separately reported.
- Resistor length for 1.248 MOhm is about 850 um at W = 1.41 um (603 squares) with the SKY130 xhigh-po model; layout area is not evaluated.
