Alphonsusadt/Mixed-Signal-Delta-Sigma-ADC/blocks/03_StrongARM/sim/results/mismatch_1_seed1001/summary.md

# StrongARM Monte Carlo mismatch — results
**Verdict:** `INSUFFICIENT_SEEDS`
**Samples:** 1/1
**Startup .lib warnings:** 0 seed(s); review ~/.spiceinit and actual PDK before trusting MC statistics
**Corner:** `tt_mm` | **Seeds:** 1001 to 1001
**Offset interval width:** 39.062 µV
**Mean offset:** 2.6367200000000004 mV
**Sample SD:** None mV
**Min/max:** 2.6367200000000004 / 2.6367200000000004 mV

Each offset estimate is the midpoint of a bracketed transition between opposite comparator decisions.
These results do not prove production yield, physical input offset at silicon, or post-layout timing.
**PDK hash:** `48de7c677e2c6e7d09b2559279de9f818be71010a4aa933d728eb4db3b133c84`
