Alphonsusadt/Mixed-Signal-Delta-Sigma-ADC/blocks/03_StrongARM/sim/results_parallel/mismatch_200_seed1001/summary.md

# StrongARM Monte Carlo mismatch — results
**Verdict:** `MC_DATA_AVAILABLE_NOT_SILICON_YIELD`
**Samples:** 200/200
**Parallel workers:** 4 | **Wall time:** 3404.63 s
**Startup .lib warnings:** 0 seed(s); review ~/.spiceinit and actual PDK before trusting MC statistics
**Corner:** `tt_mm` | **Seeds:** 1001 to 1200
**Offset interval width:** 39.062 µV
**Mean offset:** 0.443164215 mV
**Sample SD:** 2.4714889470227974 mV
**Min/max:** -5.7226550000000005 / 6.89453 mV

Each offset estimate is the midpoint of a bracketed transition between opposite comparator decisions.
These results do not prove production yield, physical input offset at silicon, or post-layout timing.
**PDK hash:** `48de7c677e2c6e7d09b2559279de9f818be71010a4aa933d728eb4db3b133c84`
