Alphonsusadt/Mixed-Signal-Delta-Sigma-ADC/results/tahap2_3/README.md

# Hasil tahap 2 dan 3 (pre-layout, TT 1.8 V 27 C, nominal)
Status: MEASURED_NOT_FINAL (tidak ada batas penerimaan numerik).
- hold_summary.txt: pedestal turn-off Block 5 (LVT). Baris E1 pada 450 ns berbeda dari angka smoke
  dinamis lama karena stimulus asli smoke tidak tersedia; penyebabnya belum dipastikan (E7 belum dijalankan).
- mim_summary.txt: kapasitansi cap_mim_m3_1; MF diabaikan model, hanya m yang mengalikan.
