Alphonsusadt/Mixed-Signal-Delta-Sigma-ADC/blocks/06_Clock_gen/results/mc/fs_m40_1p62/mc_summary.csv

seed | status | gap_min_ns | gap_1f2r_ns | gap_2f1r_ns | width_min_ns | w_phi1_ns | w_phi2_ns | ovl_mV | pass
2001 | MEASURED_NOT_FINAL | 14.477699999999999 | 14.477699999999999 | 15.185500000000001 | 109.702 | 109.702 | 110.63499999999999 | 0.0034799148542382593 | 1
2002 | MEASURED_NOT_FINAL | 14.8829 | 16.6271 | 14.8829 | 108.458 | 110.032 | 108.458 | 0.0035639316564079508 | 1
2004 | MEASURED_NOT_FINAL | 21.5976 | 28.8601 | 21.5976 | 96.2149 | 103.327 | 96.2149 | 0.0034685530570167772 | 0
2003 | MEASURED_NOT_FINAL | 24.156499999999998 | 27.2455 | 24.156499999999998 | 97.8578 | 100.74 | 97.8578 | 0.003514131799623147 | 0
2005 | MEASURED_NOT_FINAL | 27.1581 | 27.1581 | 27.497 | 97.4041 | 97.4041 | 97.9409 | 0.003474709182092269 | 0
2006 | MEASURED_NOT_FINAL | 21.282799999999998 | 21.282799999999998 | 21.605500000000003 | 103.301 | 103.301 | 103.811 | 0.003587514712432603 | 1
2007 | MEASURED_NOT_FINAL | 21.368299999999998 | 25.9268 | 21.368299999999998 | 99.18220000000001 | 103.52300000000001 | 99.18220000000001 | 0.003407573578576515 | 0
2008 | MEASURED_NOT_FINAL | 19.7026 | 20.9964 | 19.7026 | 104.11500000000001 | 105.18599999999999 | 104.11500000000001 | 0.003477681168927222 | 1
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
