Alphonsusadt/Mixed-Signal-Delta-Sigma-ADC/blocks/06_Clock_gen/results/mc/sf_125_1p98/mc_summary.csv

seed | status | gap_min_ns | gap_1f2r_ns | gap_2f1r_ns | width_min_ns | w_phi1_ns | w_phi2_ns | ovl_mV | pass
2002 | MEASURED_NOT_FINAL | 8.18751 | 8.71552 | 8.18751 | 116.32 | 116.777 | 116.32 | 0.034410799800304585 | 1
2001 | MEASURED_NOT_FINAL | 8.000820000000001 | 8.000820000000001 | 8.31064 | 116.636 | 116.636 | 117.05199999999999 | 0.03808029128905984 | 1
2003 | MEASURED_NOT_FINAL | 11.1091 | 11.7807 | 11.1091 | 113.271 | 113.839 | 113.271 | 0.03346185356377697 | 1
2004 | MEASURED_NOT_FINAL | 10.4275 | 12.2101 | 10.4275 | 112.818 | 114.545 | 112.818 | 0.037046021007522696 | 1
2005 | MEASURED_NOT_FINAL | 11.777800000000001 | 11.777800000000001 | 11.9464 | 113.01299999999999 | 113.01299999999999 | 113.263 | 0.04366575111060068 | 1
2006 | MEASURED_NOT_FINAL | 10.123700000000001 | 10.123700000000001 | 10.2161 | 114.734 | 114.734 | 114.926 | 0.0383119558322398 | 1
2007 | MEASURED_NOT_FINAL | 10.2406 | 11.4816 | 10.2406 | 113.57000000000001 | 114.707 | 113.57000000000001 | 0.04434078481740149 | 1
2008 | MEASURED_NOT_FINAL | 9.63716 | 10.026200000000001 | 9.63716 | 115.03399999999999 | 115.30199999999999 | 115.03399999999999 | 0.03921262520244483 | 1
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
