Alphonsusadt/Mixed-Signal-Delta-Sigma-ADC/blocks/06_Clock_gen/results/mc/tt_27_1p8/mc_summary.csv

seed | status | gap_min_ns | gap_1f2r_ns | gap_2f1r_ns | width_min_ns | w_phi1_ns | w_phi2_ns | ovl_mV | pass
2001 | MEASURED_NOT_FINAL | 10.5245 | 10.5245 | 10.969899999999999 | 113.943 | 113.943 | 114.563 | 0.004014289675490427 | 1
2002 | MEASURED_NOT_FINAL | 10.7952 | 11.7241 | 10.7952 | 113.342 | 114.139 | 113.342 | 0.004079702669348915 | 1
2003 | MEASURED_NOT_FINAL | 15.867799999999999 | 17.2699 | 15.867799999999999 | 107.81099999999999 | 109.051 | 107.81099999999999 | 0.004069232078701851 | 1
2004 | MEASURED_NOT_FINAL | 14.6094 | 18.0977 | 14.6094 | 106.96 | 110.333 | 106.96 | 0.004021006396727997 | 1
2006 | MEASURED_NOT_FINAL | 14.241100000000001 | 14.241100000000001 | 14.4026 | 110.522 | 110.522 | 110.834 | 0.004390436355298532 | 1
2005 | MEASURED_NOT_FINAL | 17.3245 | 17.3245 | 17.5473 | 107.377 | 107.377 | 107.75099999999999 | 0.004394060305878065 | 1
2007 | MEASURED_NOT_FINAL | 14.372 | 16.649900000000002 | 14.372 | 108.435 | 110.543 | 108.435 | 0.004386270956857486 | 1
2008 | MEASURED_NOT_FINAL | 13.3679 | 14.047 | 13.3679 | 111.041 | 111.544 | 111.041 | 0.004505376021819487 | 1
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
