Alphonsusadt/Mixed-Signal-Delta-Sigma-ADC/blocks/06_Clock_gen/results/pvt/baseline_fixed_bias_pvt_summary.csv

corner | temp | vdd | status | dt_1f2r | dt_2f1r | w_phi1 | w_phi2 | skew_p1r | skew_p1f | tr_phi1 | tf_phi1 | tr_phi2 | tf_phi2 | tr_phi1b | tf_phi1b | tr_phi2b | tf_phi2b | ovl_prod | phi1_max | phi2_max | ivdd_avg | minmax_phi_V | phi_max_V
tt | -40 | 1.62 | FAIL |  |  |  |  |  |  |  |  |  |  |  |  |  |  | 6.18445e-12 | 3.47192e-06 | 6.59786e-06 | -2.84191e-07 | 2.920494985033159e-06 | 6.95899007177931e-06
tt | -40 | 1.8 | MEASURED_NOT_FINAL | 6.92786e-08 | 6.94715e-08 | 5.53834e-08 | 5.58664e-08 | 3.73279e-11 | 2.38215e-10 | 4.94149e-10 | 2.43547e-10 | 4.94802e-10 | 2.43571e-10 | 7.46342e-10 | 5.50787e-10 | 7.46348e-10 | 5.50612e-10 | 6.35967e-06 | 1.81143 | 1.81138 | -8.20295e-06 | 3.595924366754451e-06 | 1.81142989748957
tt | -40 | 1.98 | MEASURED_NOT_FINAL | 6.57384e-09 | 6.60695e-09 | 1.18275e-07 | 1.18544e-07 | -4.62986e-11 | 2.22816e-10 | 4.42083e-10 | 2.22535e-10 | 4.40414e-10 | 2.22585e-10 | 6.4806e-10 | 3.35032e-10 | 6.49305e-10 | 3.34873e-10 | 7.61236e-06 | 1.99156 | 1.99154 | -5.84747e-06 | 3.963927790689979e-06 | 1.991557281631073
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
