Alphonsusadt/Mixed-Signal-Delta-Sigma-ADC/blocks/06_Clock_gen/results/mc/fs_m40_1p62/mc_hist.png

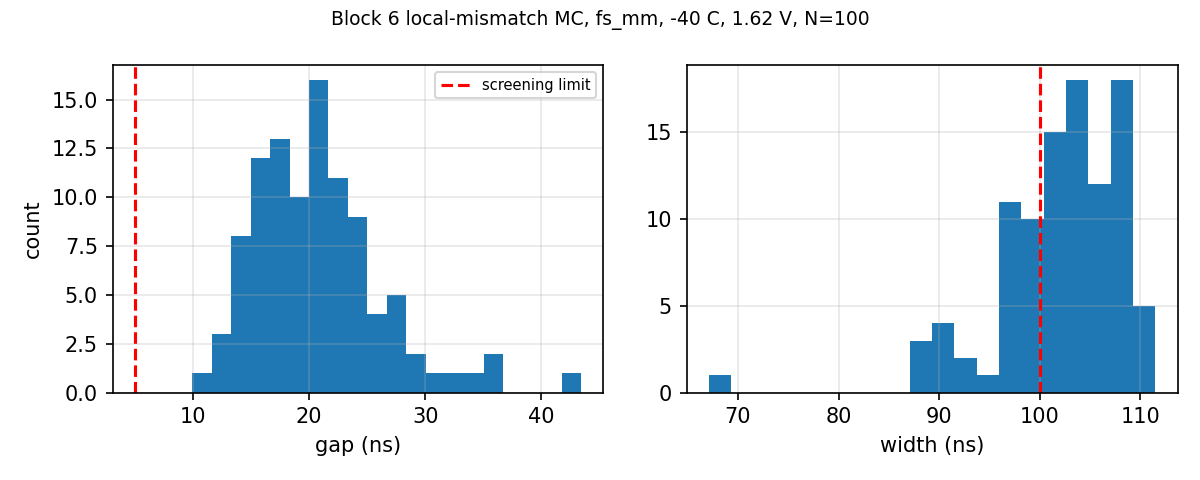
blocks/06_Clock_gen/results/mc/fs_m40_1p62/mc_hist.png
