Alphonsusadt/Mixed-Signal-Delta-Sigma-ADC/blocks/06_Clock_gen/results/mc/sf_125_1p98/mc_hist.png

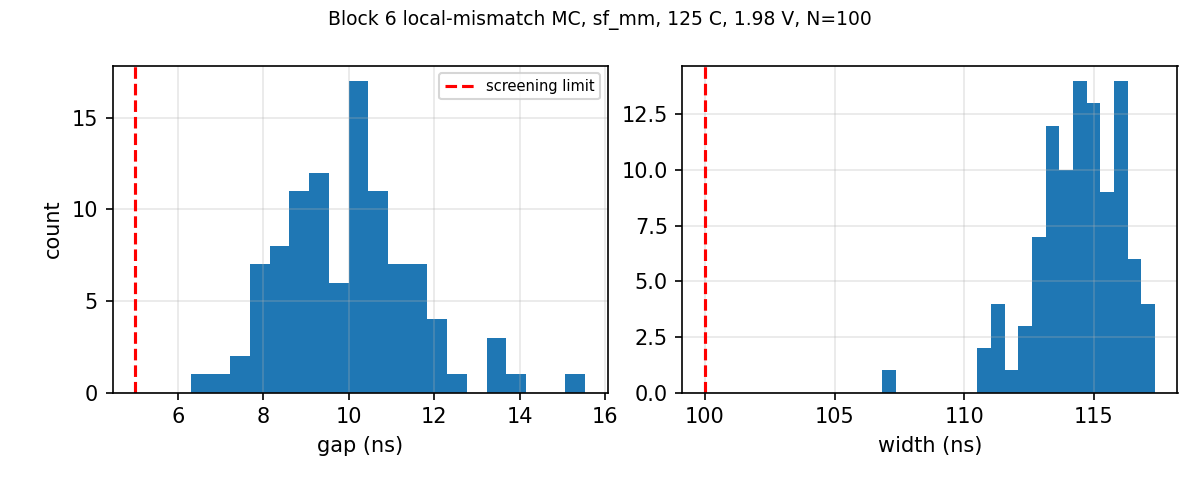
blocks/06_Clock_gen/results/mc/sf_125_1p98/mc_hist.png
