Alphonsusadt/Mixed-Signal-Delta-Sigma-ADC/blocks/06_Clock_gen/results/mc/tt_27_1p8/mc_hist.png

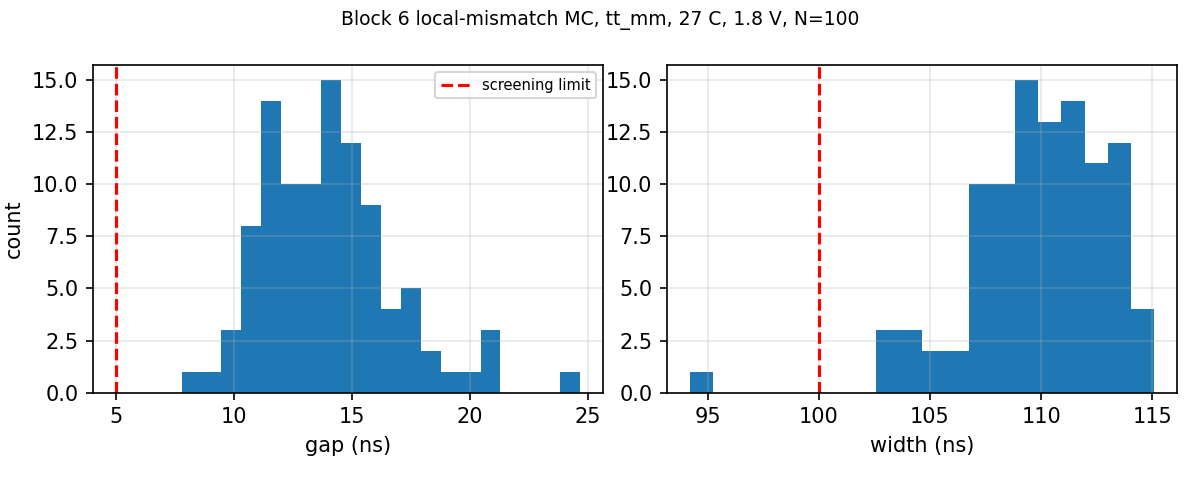
blocks/06_Clock_gen/results/mc/tt_27_1p8/mc_hist.png
