Alphonsusadt/Mixed-Signal-Delta-Sigma-ADC/blocks/06_Clock_gen/results/pvt/pvt_gap_compare.png

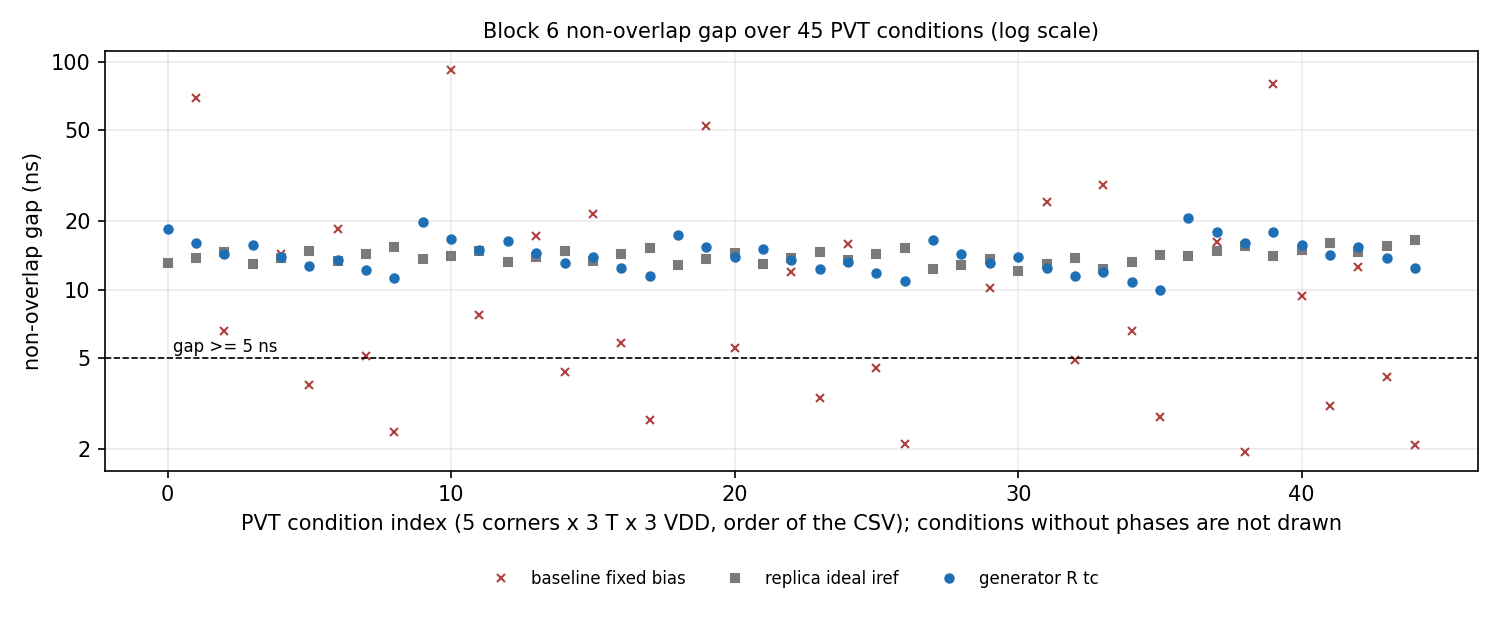
blocks/06_Clock_gen/results/pvt/pvt_gap_compare.png
