Alphonsusadt/Mixed-Signal-Delta-Sigma-ADC/results/pvt_block6/pvt_gap.png

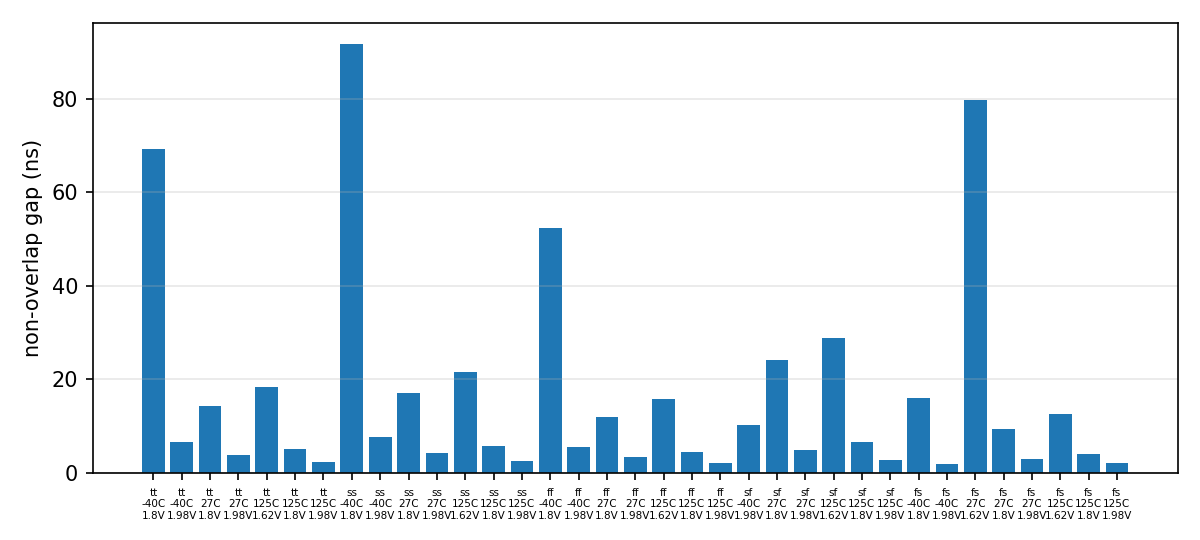
results/pvt_block6/pvt_gap.png
