Alphonsusadt/Mixed-Signal-Delta-Sigma-ADC/(commit log)

2026-09-23 initial commit: OTA Schematic & testband
    [OTA.sch, tb_OTA_AC.sch]
2026-09-27 repair OTA
    [OTA.sch, tb_OTA_AC.sch]
2026-10-05 do simultion and verification
    [OTA_experiment.sch, tb_OTA_AC_experiment.sch, tb_OTA_NOISE_experiment.sch, tb_OTA_Power_experiment.sch, tb_OTA_Tran_CL_experiment.sch, tb_OTA_Tran_SR_experiment.sch, tb_OTA_Tran_experiment.sch]
2026-10-05 simulation noise and cmrr
    [tb_OTA_CMRR_experiment.sch]
2026-10-05 simulation pssr positif
    [tb_OTA_PSRRP_experiment.sch]
2026-10-05 simulation final psrr negative
    [tb_OTA_PSRRN_experiment.sch]
2026-10-05 find vbias voltase in some temp
    [tb_OTA_BIAS_TEMP_experiment.sch, tb_OTA_PVT_experiment.sch]
2026-10-05 final simulation and documentation
    [tb_OTA_BIAS_TEMP_experiment.sch, tb_OTA_PVT_experiment.sch, tb_OTA_TEMP_AC_verify.sch]
2026-10-06 add TG
    [TG.sch]
2026-10-07 make tg
    [TG.sch]
2026-10-08 make and simulation cmfb
    [CMFB.sch, OTA_CMFB.sch, TG.sch, TG_cell.sch, Test_TG.sch, tb_CMFB.sch, tb_OTA_CMFB_firststage_closedloop.sch, tb_OTA_CMFB_firststage_sign.sch]
2026-10-08 final foor make cmfb, from make schematic until simulation and documentation
    [tb_CMFB_PVT_01_TT_1v80_27C.sch, tb_CMFB_PVT_02_TT_1v80_m40C.sch, tb_CMFB_PVT_03_TT_1v80_125C.sch, tb_CMFB_PVT_04_TT_1v62_27C.sch, tb_CMFB_PVT_05_TT_1v98_27C.sch, tb_CMFB_PVT_06_SS_1v80_27C.sch, tb_CMFB_PVT_07_FF_1v80_27C.sch, tb_CMFB_STABILITY_100nA_CMstep_TT.sch]
2026-10-09 maka strong arm
    [StrongARM.sch]
2026-10-09 make testbench
    [tb_StrongARM_Transient.sch]
2026-10-09 testbecnh first
    [tb_StrongARM_Transient.sch]
2026-10-09 montecarlo analysis for normalizatioon
    [offset_samples.csv, tb_StrongARM_MC.sch]
2026-10-09 make testbanch for arm strong power analysis
    [tb_StrongARM_Power.sch]
2026-10-09 make testbanch for arm strong power analysis but porality test
    [tb_StrongARM_Power.sch]
2026-10-09 make testbanch for power with capasitor input
    [tb_StrongARM_Power.sch]
2026-10-09 make testbench power aand time delay
    [tb_StrongARM_Power.sch]
2026-10-10 final for simulatioon PVT testing
    [NAND2.sch, tb_StrongARM_Kickback.sch, tb_StrongARM_PVT.sch, tb_StrongARM_Power.sch]
2026-10-10 make nand and latch file
    [NAND2.sch, SR_Latch.sch, tb_NAND2.sch, tb_SR_Latch.sch]
2026-10-16 testing and analys ron case
2026-10-16 testing and analys galat switching
2026-11-02 Block 5: testbench track-and-hold E1-E8 dan cek MIM
2026-11-02 Stage 2-3: hold/aperture/level analysis runner and result summaries
2026-11-02 Stage 6: OTA AC comparison MF=80 vs MF=100 (runner, testbenches, results)
2026-11-05 Block 6: NONOV non-overlapping clock generator (SKY130)
    Schematics, testbenches 6A-6E, netlist generator and run driver for the
    NONOV clock generator after Spilka et al. (DDECS 2012): XOR -> current-starved
    delay -> AND2 -> XOR, 80 MOS.
    Nominal TT / 1.8 V / 27 C, pre-layout, VBN 0.70 V / VBP 0.71 V:
    non-overlap gap 14.3 ns, phase width 110.6 ns, no overlap.
    Status: MEASURED_NOT_FINAL.
2026-11-05 Closed loop: drive the modulator from Block 6 phases and clock chain
    Run the loop with phi1/phi2 from the Block 6 NONOV instead of ideal sources,
    and derive the comparator clock from phi2b through an inverter chain (N=2).
    SNDR at OSR 80: ideal 75.37 dB, Block 6 73.87 dB, Block 6 + clock chain
    72.44 dB. HD2/HD3 rise by about 3 dB per step. The differences are only
    slightly above single-run statistical scatter (about 1 dB), so no firm
    degradation is claimed. No loop failure or saturation observed.
2026-11-06 Block 6: add PVT sweep and bias-map drivers (Python + ngspice)
2026-11-06 chore: stop tracking working notes, console dumps and per-sample MC decks; extend .gitignore
2026-11-06 chore: ignore generated Block 6 sim output and per-case PVT decks
2026-11-09 Top level: Xschem schematic of the closed-loop modulator, SD_STAGE, FB_SAMP, B6_BIASGEN
